Laborprojekt/005_Projekt_Kontrollpanel/Dokumentation/Klemmreihe.jpeg

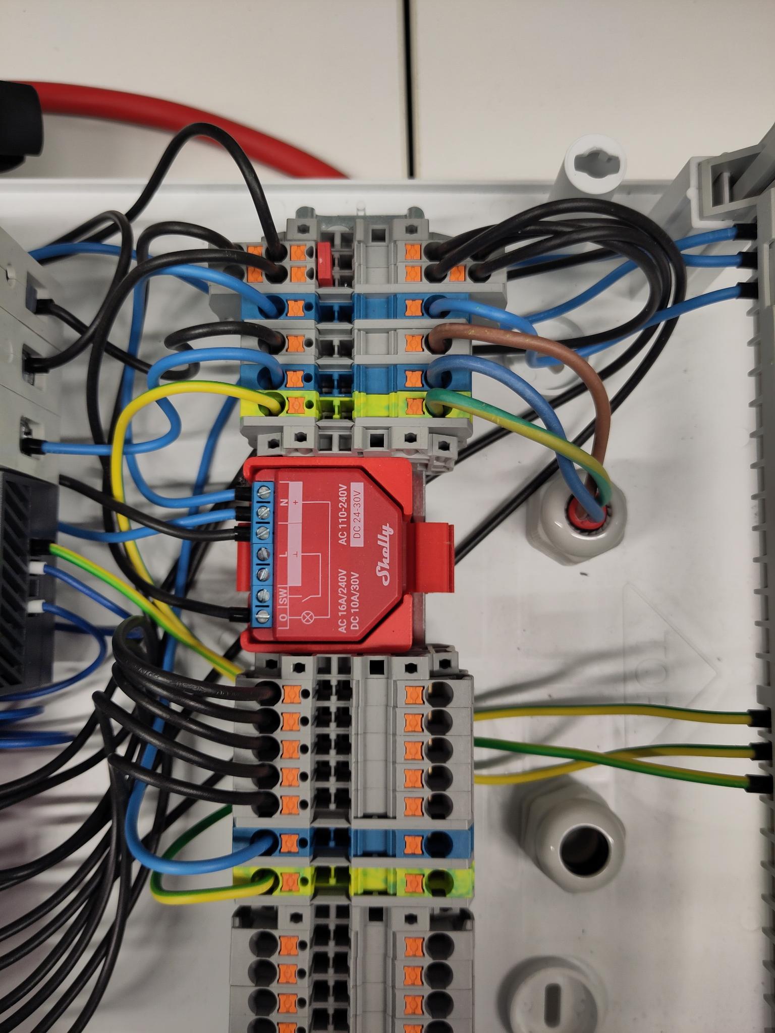
Dokumentation/Klemmreihe.jpeg
