Laborprojekt/005_Projekt_Kontrollpanel/Checkliste IoT Projekt.docx

# Checkliste IoT Projekt

Ansteuerung Node-Red

☒ reboot Relais

☒ Steckdosen einzeln schaltbar

☒ Steckdosen in Gruppen schaltbar

☒ Shelly Schaltbar

☒ Visualisierung

☒ Energiemesswerte

☒ AHT20 Messwerte

☒ Datenbank einbinden

☒ Logs

☒ Messwerte

ESP32

☒ AHT20 auslesen

☐ Display

☒ Energiemesswerte visualisieren

☒ AHT20 Messwerte visualisieren

☐ Display ein- und ausschalten

☐Interrupt Taster

☐ Schuko 1&2

☐ Schuko 3&4

☐ Logs generieren

☐ MQTT-Verbindungen

☐ AHT20 Messwerte übermitteln

☐ Änderungen Schaltzustand

☐Fehlermeldungen
