Laborprojekt/005_Projekt_Kontrollpanel/Dokumentation/Systemarchitektur.pptx

Systemarchitektur

Komponenten
- Prozessor
- Sensor
- Aktor
- Software

Verbindungen:
- MQTT/WIFI
- I2C
- Kupfer
- Interne Schnittstelle

Taster

Schaltzustand

Smartphone

Energiewerte

Schaltbefehl int. Relais

Energiewerte
Schaltzustand

Shelly Plus 1PM

Schaltbefehl int. Relais

AHT 20

Temperatur
Luftfeuchtigkeit

ESP32-S3 Master

Energie Messwerte
Raum Messwerte

Raum Messwerte, Logs/Events
Schaltbefehl Relais

Energiewerte

Schaltbefehl
Relais

Logs/Events

MQTT-Broker

Schaltbefehl Relais, Schaltbefehl Shelly

Logs/Events, Raumwerte, Energiewerte
Schaltzustand Shelly

Node-Red / UI

Logs
Raumwerte
Energiewertet

Display

ESP32-S3
Sub

Schaltbefehl

Relais

Maria-DB
