Laborprojekt/005_Projekt_Kontrollpanel/Ideenskizze/Architektur Projektarbeit.pptx

5. Systemarchitektur

Komponenten:
- Prozessor
- Sensor
- Aktor
- Software

Verbindungen:
- MQTT
- I2C
- Kupfer
- Interne Schnittstellen

Shelly Plus 1 PM

Taster

Schaltzustand

Schaltzustand Aktor

Energie Messwerte

Raum Messwerte, Zustand Taster,
Zustand Steckdose, Logs

AHT20

Temperatur
Luftfeuchtigkeit

ESP32-S3

Schaltzustand

Relais

MQTT-Broker

Messwerte, Logs

Node-RED

Messwerte
Energie und Raum

Energie Messwerte, Zustand Button

Zustand Button

Messwerte
Logs

MariaDB

Display
