Laborprojekt/005_Projekt_Kontrollpanel/Dokumentation/Projektdokumentation.pdf

## BZTG Oldenburg

06.05.2025

# DOKUMENTATION PROJEKTARBEIT

## Jonah Eberlei

## Inhaltsverzeichnis

## Projektbeschreibung und Ideenskizze

## 1. Allgemeine Informationen

- Projektname: Kontrollpanel
- Datum: 11.03.25 – 06.05.25

## 2. Projektbeschreibung

Kurzbeschreibung:

Über Taster und eine Weboberfläche werden Steckdosen geschaltet. Mit zwei Sensoren werden die Raum- und Leistungsdaten erfasst und später auf der Weboberfläche visualisiert. Zusätzlich zur Weboberfläche gibt es ein kleines Display, welches die Daten ebenfalls anzeigt und eine Datenbank, in der die Daten abgelegt werden.

## 3. Anforderungen und Funktionalitäten

Sensorik

- Luftfeuchtigkeit
- Temperatur
- Energiebezug Steckdosen, aktuell und alltime

Aktoren-Steuerung

- Steckdosen
- ESP Hardreset

Webinterface & Benutzerinteraktion

- Visualisierung Energiebezug
- Steckdosen einzeln oder als Gruppe schalten
- Button für ESP Hardreset

## 4. Benötigte Komponenten

### 4.1 Hardware

### 4.2 Software & Datenbank

Komponente | Technologie | Funktion
Microcontroller-Code MicroPython
Webinterface | Node-Red | Visualisierung und Usereingaben
Datenbank | MariaDB
Komponente | Modell/Typ | Funktion
Mikrocontroller | ESP32-S3-DevKit-C
Sensor 1 | AHT20 | Temperatur und Luftfeuchtigkeit
Sensor 2 | Shelly plus 1PM | Energieüberwachung und 1 Schaltaktor
Aktor 1 | SRD-03VDC SL C | 10A Relais
Aktor 2 | 1,69“ IPS Display | Visualisierung
Stromversorgung Mean Well HDR-60-5 | 230V –> 5V Netzteil
Step-Down Modul 3V3 | Spannungsversorgung Relais
Siemens 5SL61166 | B16 LS
Siemens 5SU13566KK10 | B10, 0.03A RCBO
Weitere Bauteile | Taster24V DC, NO | Einschalten des Displays und der Steckdosen
| Hutschiene | Montage Netzteil und RCBO
Steckdosen Gira System/Standart 55
Verschraubung M16 | Zugentlastung
Schuko Stecker | Verbindung Stromnetz
Unterverteilung
Verbindungs und Kleinmaterial

## 6. Zeitplanung (Meilensteine)

Datum | Aufgabe
KW 1 | Detailplanung, Material beschaen
KW 2 | Hardware für Tests zusammenbauen, Ansteuerung Relais
KW 3 | Mit MQTT-Broker und Node-Red verbinden, Shelly einbinden
KW 4 | Taster, AHT und Display einbinden
KW 5 | Node-Red Visualisierung und Buttons einbinden
KW 6 | Logs implementieren, Datenbank verbinden
KW 7 | Bug Fix und Optimierung
KW 8 | Dokumentation

## 7. Offene Fragen & Herausforderungen

- - Der Shelly Schaltaktor arbeitet nicht sauber als NC Kontakt
- - Die Relais benötigen zu viel Energie vom ESP, wenn alle eingeschaltet sind
- - Die Relais reagieren nicht sicher auf Zustandsänderungen

## 8. Zielsetzung

- Das Panel soll mir nach Abschluss der Projektarbeit eine detaillierte Auskunft über den Energieverbrauch der angeschlossenen Geräte und die Umgebungsbedingungen im Raum geben.

## 9. Fazit

Der Frühe Umbau, von der Hutschiene in die Unterverteilung hat alle sehr übersichtlich gestaltet und alle weiteren arbeiten vereinfacht. Durch die Vorbereitung im Unterricht, war die Programmierung der MQTT-Schnittstelle und Node-Red schnell grundlegend bearbeitet. Durch die Unterstützung der KI-Modelle waren auch die fehlenden Java-Script Kenntnisse, die ebenfalls für den Shelly benötigt werden, kein großes Hindernis und die Fehler konnten schnell beseitigt werden.
Was ich stark unterschätzt habe, war die Kostenentwicklung und der Einfluss von EMV auf unsere Microcontroller. Die Taster Signale (Interrupts) leiden aufgrund der geringen Spannung sehr unter Einstreuungen, die u.a. beim Schalten des internen Shelly Relais entstehen. Für einen praktischen Anwendungsfall würde ich meine Taster nicht erneut über einen ESP die Relais ansteuern lassen oder die Steuerspannung erhöhen. Der Eekt der Einkopplungen wird durch die parallel liegenden Leitungen und die allgemeine Länge der Leitung verstärkt. 24V wäre beispielsweise deutlich weniger störanfällig als die 3,3V des ESP. Direkt alles nur über Shelly steuern zu lassen oder als Controller eine LOGO/SPS zu nehmen, würde die Fehleranfälligkeit und die Kostenentwicklung deutlich senken.

Um das ganze mit dem ESP umzusetzen war viel Kleinmaterial und teilweise auch ausprobieren nötig, bis ich das richtige Material gefunden habe. Das hat die Kosten nach oben getrieben, da es bei Leitungen zum Teil. mindestlängen gibt, die gekauft werden müssen.

Insgesamt konnte ich bei dem Projekt einige Dinge lernen, die ich in Zukunft anders machen würde. Ich hatte viel Spaß beim Zusammenbau der Unterverteilung, während meiner Leerlaufzeit bei einer Ferienveranstaltung. Ich konnte mehreren interessierten Teilis dadurch das Thema anschaulich erklären und ihnen das Feld der Elektrotechnik etwas näherbringen.

## 10. GITHUB Repository

https://github.com/Laborprojekt/005_Projekt_Kontrollpanel

## 11. Erweiterungen

- Leuchttaster, die den Schaltzustand angeben
o War integriert, musste aufgrund der EMV-Probleme aber zurückgebaut werden, als der zweite ESP die Steuerung integriert wurde. Die Spannungsversorgung der 12V LED-Ringe war nicht mehr möglich
- Remote-Red Anbindung
o Wurde bereits integriert

## Installationsanleitung Kontrollpanel

## Montage Unterverteilung:

Im ersten Schritt müssen die Löcher für die Unterverteilung am Montageort vorgebohrt werden. Die Schraubenlöcher haben einen Durchmesser von 4mm.
Abstände:
A 526mm
B 287mm
C 112mm
D 357mm
E 180mm

Quelle: https://intratec-shop.de/sicherungskasten-verteiler-aufputz-3-reihig-ip40-36-module-weisse-tuer/MKCAGH36-W

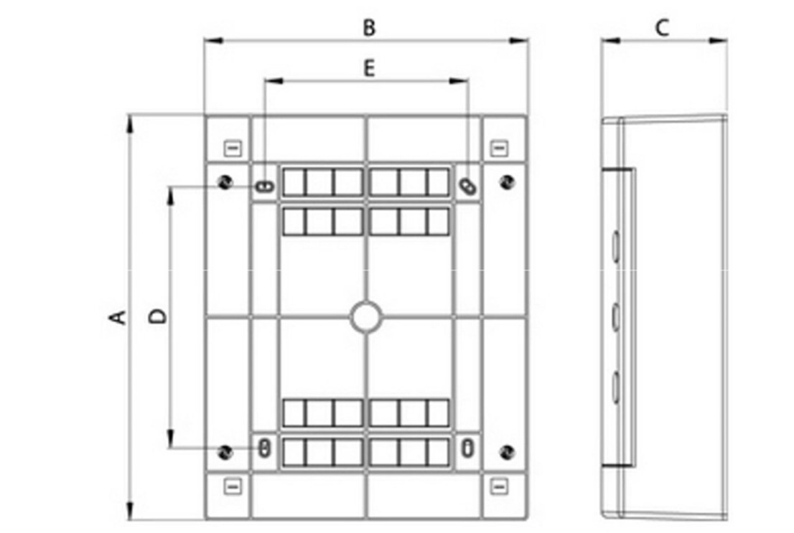
[picture p2: figure]

Wenn die Leitungen nicht unterputz verlegt wurden, müssen bei der Montage

### 40 mm-60 mm Distanzstücke verwendet werden, um den Unterverteiler von der

Montagefläche abzusetzen. Wird dies nicht getan, kann der Biegeradius der Anschlussleitung nicht eigehalten werden.

## Anschließen der Ein- und Ausspeisung

Einspeisung:
- 230V
- 1.5 mm² - 4 mm²
- Vorsicherung 16A/25A
Ausspeisung:
- 230V
- 1.5 mm² - 2.5 mm²
Strombelastbarkeit:
Einzelader: 10A / 2300 Wp
Insgesamt: 10A / 2300 Wp
Dauerlast: 8A / 1840 W

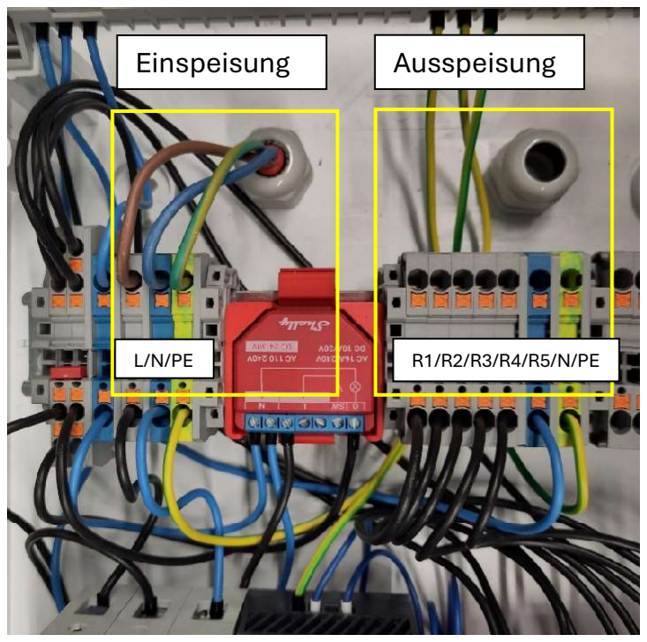
[picture p3: figure]
Einspeisung; Ausspeisung

## Inbetriebnahme durch eingewiesene EFK

- Inbetriebnahmeprüfung nach DIN VDE 0100 Teil 600 und DIN VDE 0701/0702
- Anpassen der Netzwerk- und MQTT-Parameter:
o ESP Master
o ESP Sub
o Shelly plus 1 pm
o Node-Red
o MariaDB

## Bedienungsanleitung Kontrollpanel

## 1. Hardwareinformationen

ESP32-S3-DevKitC-1
Das ESP32-DevKitC ist ein kompaktes und kostengünstiges Entwicklungsboard auf Basis des ESP32-Chips von Espressif. Es eignet sich ideal für Einsteiger und Fortgeschrittene, die IoT-, Sensor- oder Automatisierungsprojekte entwickeln wollen. Merkmale:
- Mikrocontroller: ESP32 (Dual-Core, 32 Bit, 240 MHz)
- Speicher: 520 KB SRAM, 16 MB Flash
- Konnektivität:
o WLAN 802.11 b/g/n
o Bluetooth 4.2 (Classic & BLE)
- Anschlüsse:
o GPIOs
o SPI, I2C, UART, PWM, ADC, DAC
- USB-C Anschluss: Für Programmierung und Stromversorgung (über UART-Bridge)
- Stromversorgung: 5 V/3V3
- Unterstützung: Kompatibel mit Arduino, MicroPython, ESP-IDF

Q(ESP)

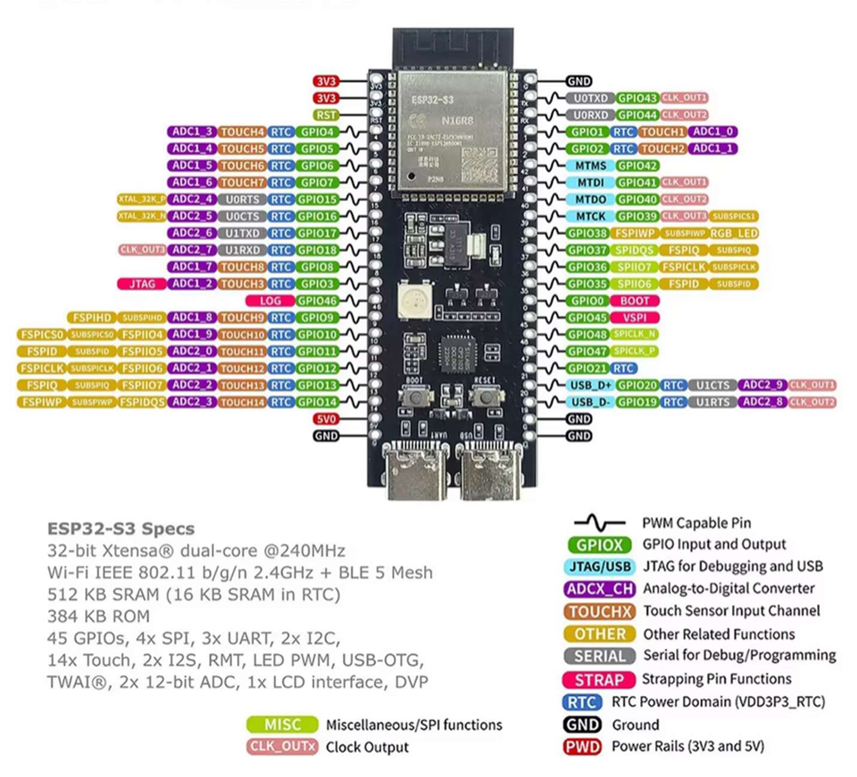
[picture p4: figure]

AHT20
Der AHT20 ist ein digitaler Sensor zur Messung von
Temperatur und relativer
Luftfeuchtigkeit.
Eigenschaften:
- Messbereich

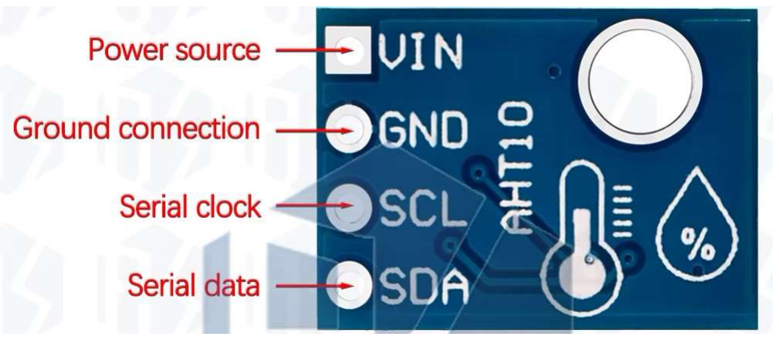
[picture p5: figure]

Temperatur: -40 °C bis +85 °C
- Genauigkeit Temperatur: ±0,3 °C
- Messbereich Luftfeuchtigkeit: 0 % bis 100 % relative Luftfeuchte
- Genauigkeit Luftfeuchtigkeit: ±2 %
- Spannungsversorgung: 2,2 V – 5,5 V
- Kommunikation: I2C

Q(AHT)
Shelly plus 1 PM

Der Shelly Plus 1PM ist ein kompakter Smart-Schalter mit integrierter Leistungsmessung, der die Fernsteuerung elektrischer Geräte über ein Smartphone, Tablet, einen PC oder ein Heimautomatisierungssystem ermöglicht.
Er kann eigenständig in einem lokalen WLAN-Netzwerk betrieben werden oder über Cloud-basierte Smart-Home-Dienste gesteuert werden. Er unterstützt zudem MQTT, WSS, TLS und kundenspezifische Zertifikate.
Der Shelly Plus 1PM kann von überall aus ferngesteuert, überwacht und konfiguriert werden, solange der Benutzer über eine Internetverbindung verfügt und das Gerät mit einem WLAN-Router und dem Internet verbunden ist.
Er lässt sich problemlos in Standard-Unterputzdosen, hinter Steckdosen und Lichtschaltern oder an anderen Orten mit begrenztem Platzangebot nachrüsten.
Der Shelly Plus 1PM verfügt über eine integrierte Weboberfläche, mit der sich das Gerät überwachen, steuern und konfigurieren lässt.

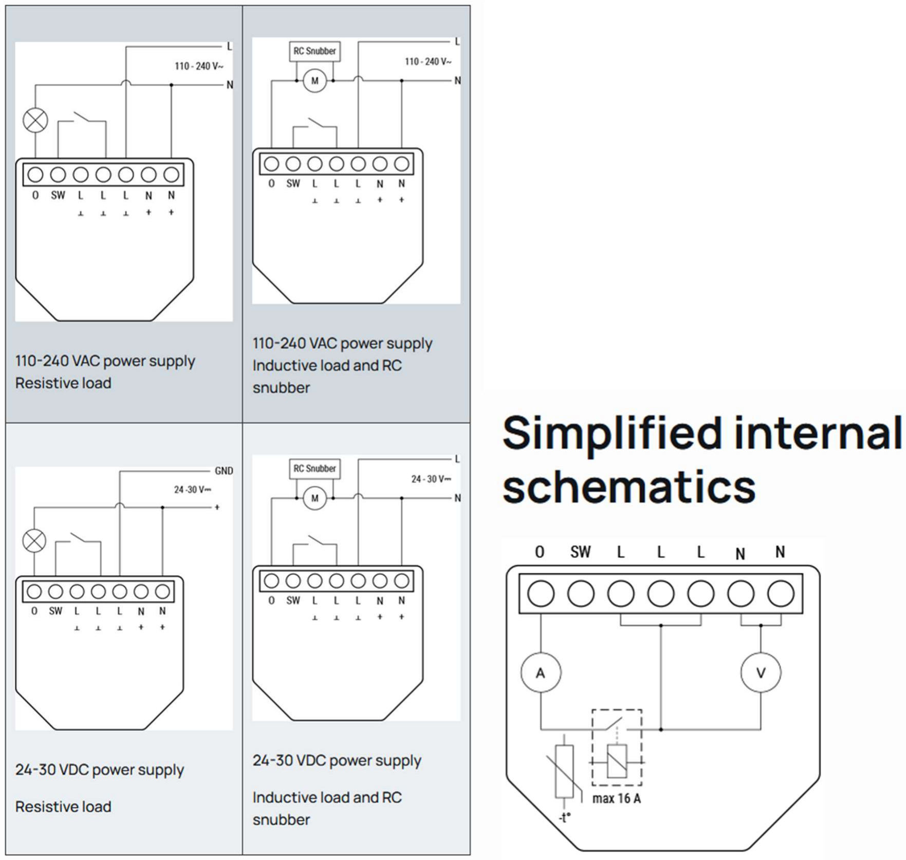
[picture p6: figure]

Q(Shelly)

ST7789V3, 1.69", 240x280p

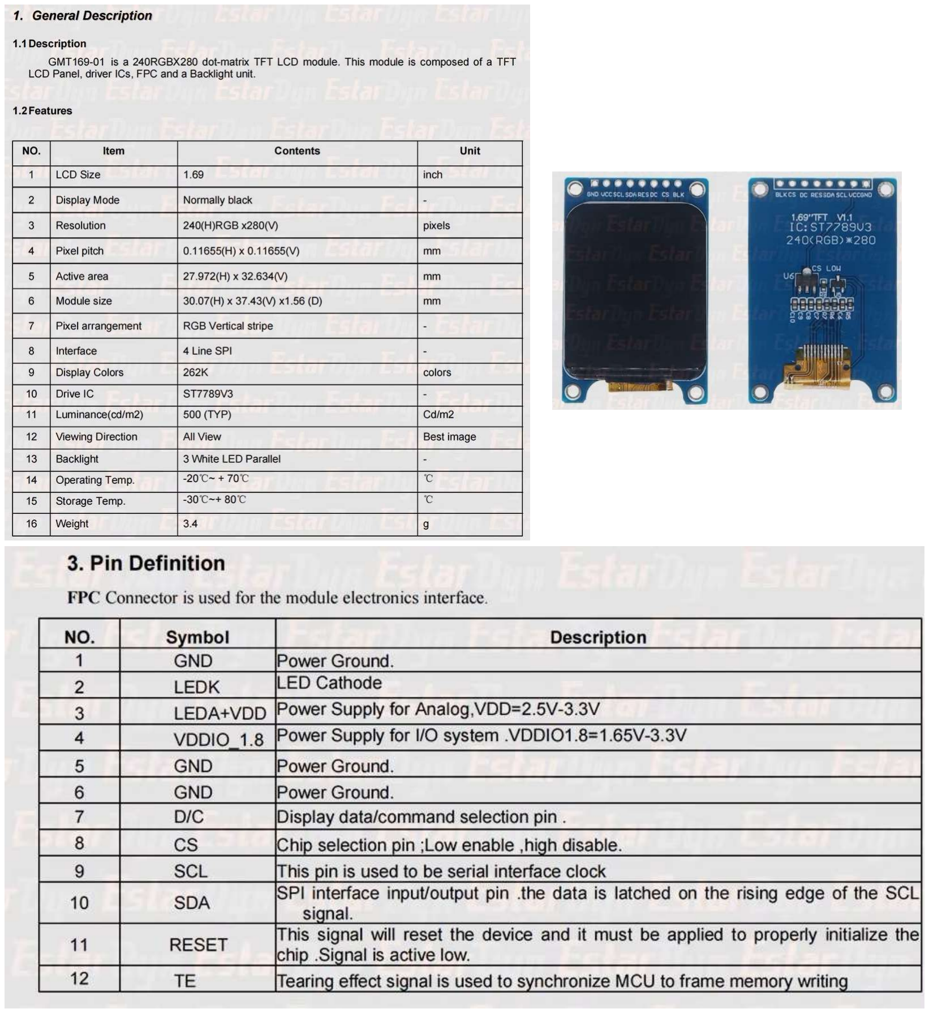
[picture p7: figure]
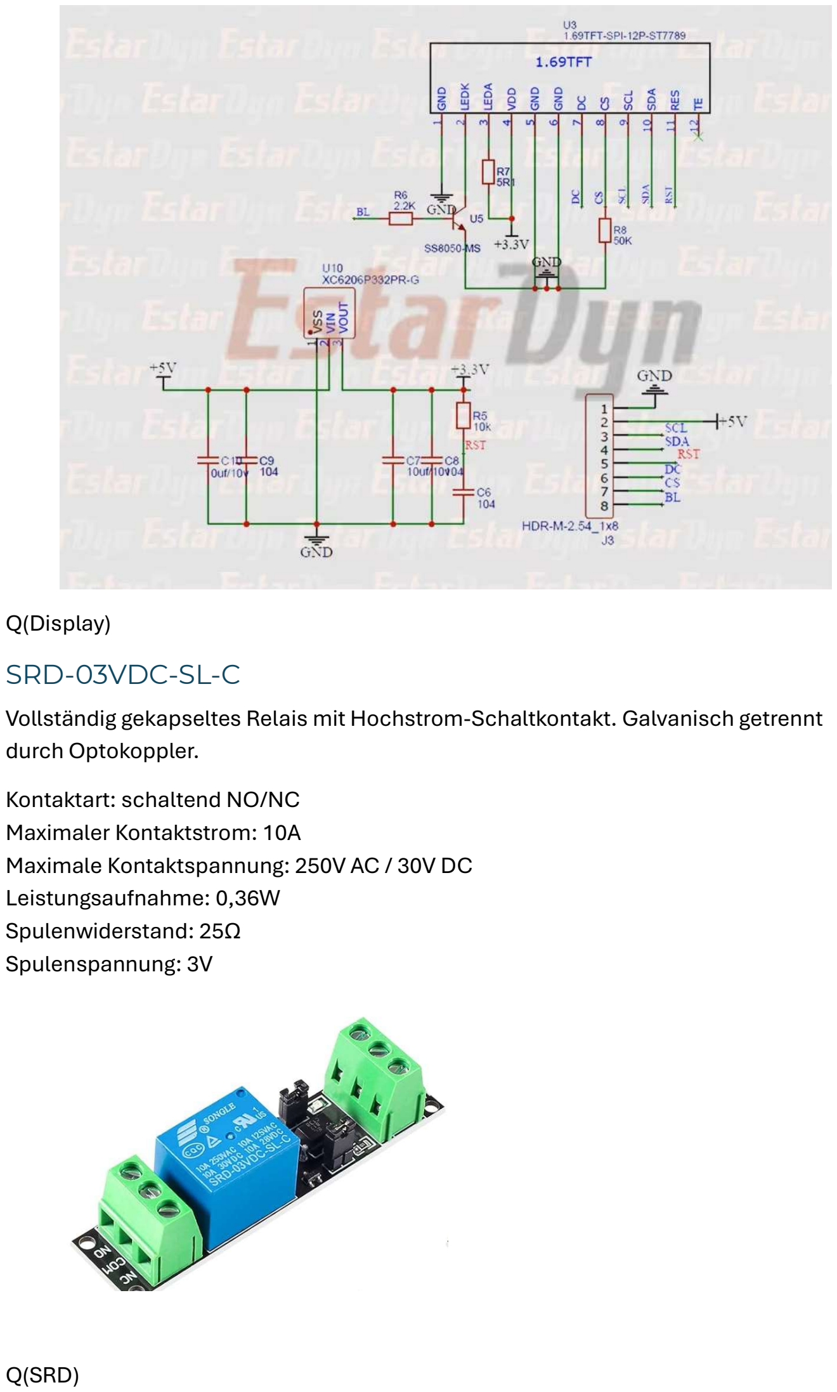
[picture p8: page 14]

Q(Display)
SRD-03VDC-SL-C
Vollständig gekapseltes Relais mit Hochstrom-Schaltkontakt. Galvanisch getrennt durch Optokoppler.
Kontaktart: schaltend NO/NC
Maximaler Kontaktstrom: 10A
Maximale Kontaktspannung: 250V AC / 30V DC Leistungsaufnahme: 0,36W
Spulenwiderstand: 25Ω
Spulenspannung: 3V

Q(SRD)

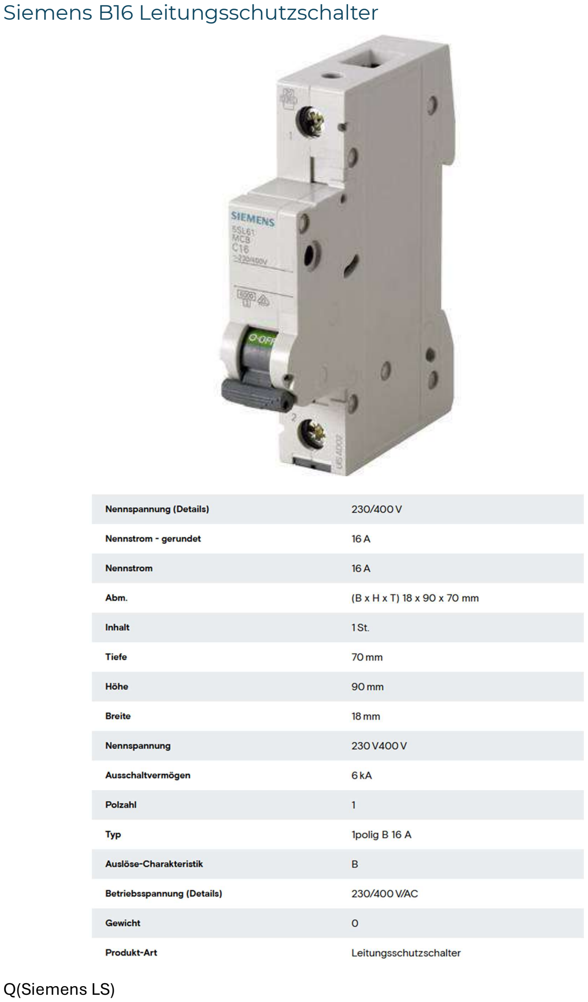
[picture p9: page 15]

Siemens B16 Leitungsschutzschalter

Q(Siemens LS)

Siemens B10 FI/LS

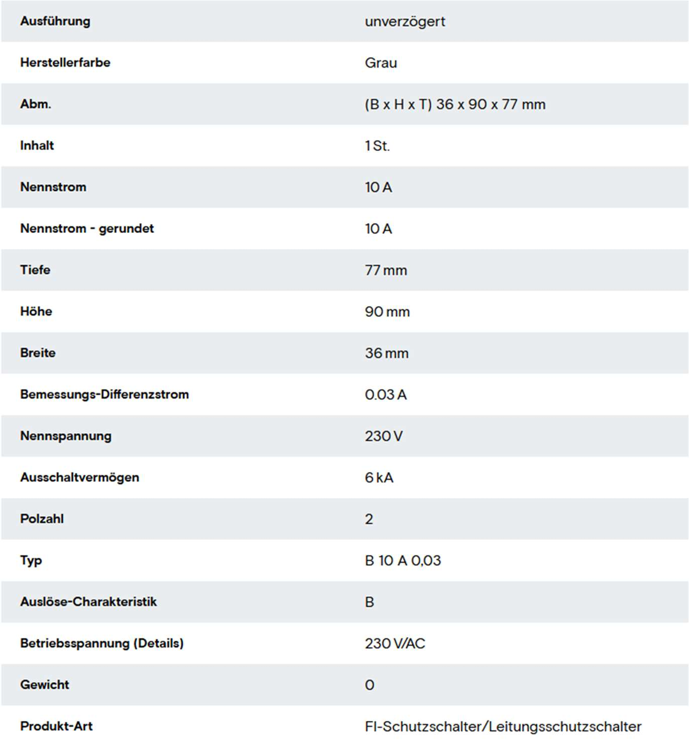
[picture p10: figure]

Q(Siemens FI/LS)

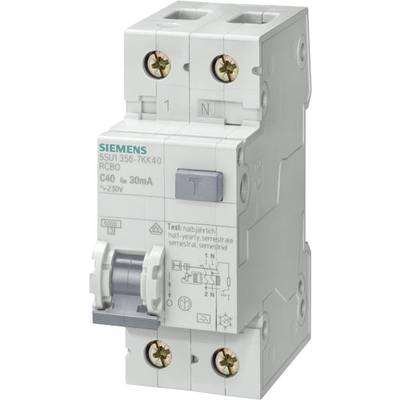
[picture p11: figure]

MeanWell HDR-60-5
Hersteller: MeanWell
Hersteller Serie: HDR-60
Herstellerartikelnummer: HDR-60-5 Anschluss Ausgang: Schraubklemmen Anschluss Netzeingang: Schraubklemmen Breite: 62mm
Höhe: 62mm
Länge: 92mm
Ausgangsspannung: +5V
Ausgangsstrom: 6,5A
Eingang (AC/DC): AC
Eingangsspannung: 115V / 230V (Universal) Eingangsspannung (min...max): 85...264VAC Leistung: 60W
Netzteil Serie: HDR-60
Netzteil Typ: Hutschienen Netzteil Stabilisierung: Konstantspannung (CV) Wirkungsgrad: 89%

Q(MeanWell HDR)

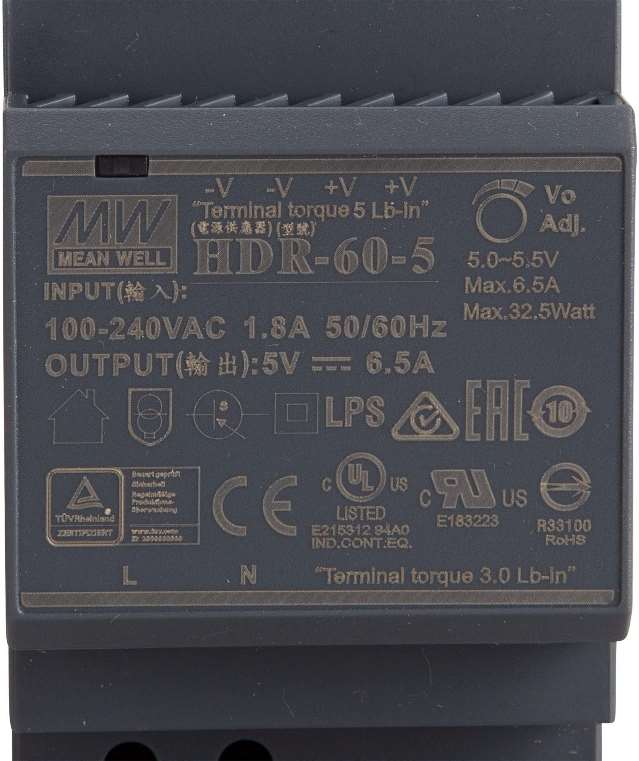
[picture p12: figure]
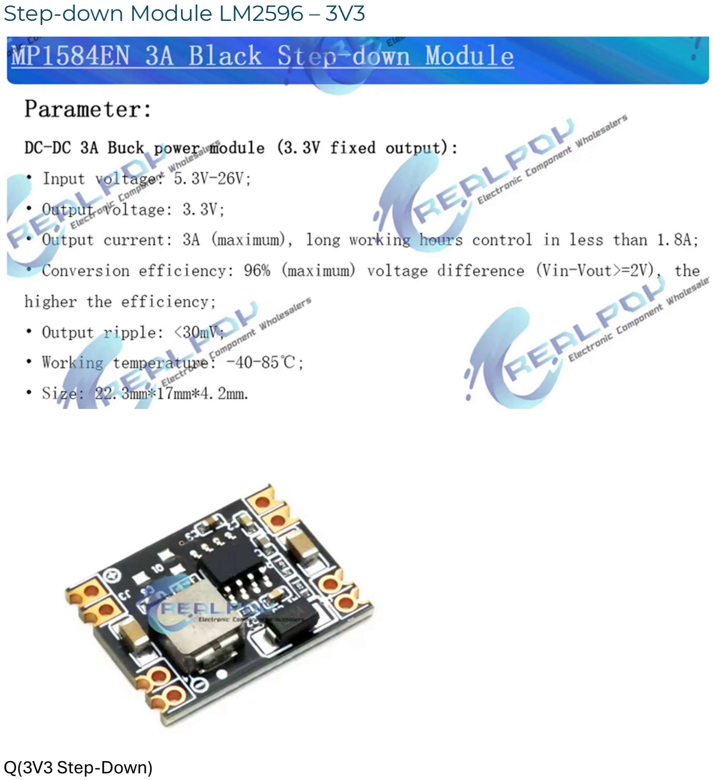
[picture p13: page 18]

Step-down Module LM2596 – 3V3

Q(3V3 Step-Down)

## 2. Systemarchitektur

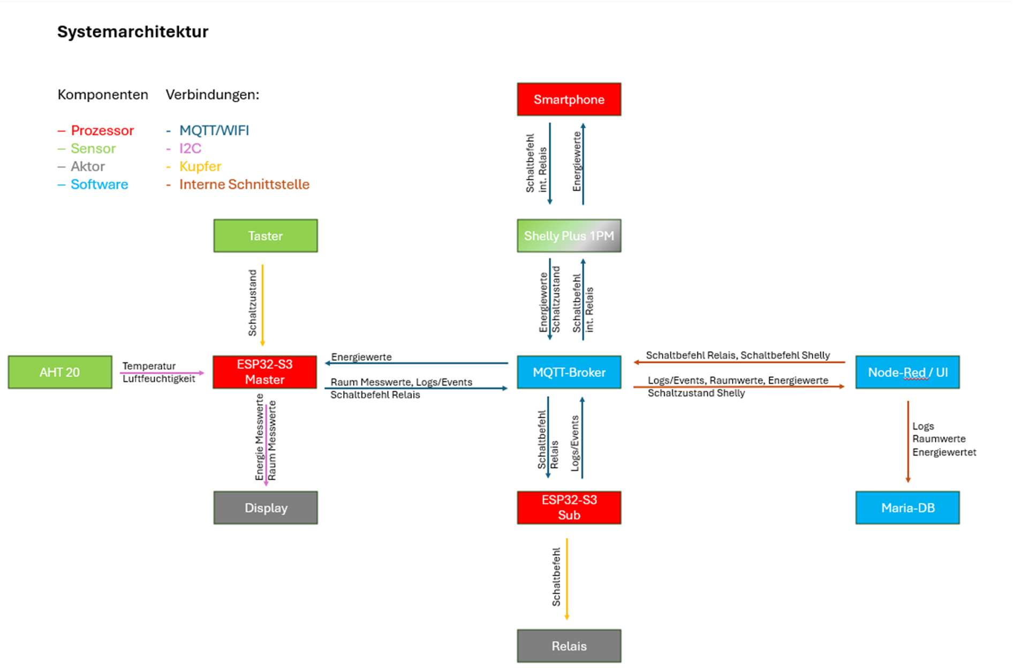
[picture p14: figure]

## 3. Broker und Datenbank

Topics
Topic | Sender | Empfänger | Beschreibung
ESP_AHT | ESP Master | Datenbank | Messwerte zu Luftfeuchtigkeit und Temperatur
ESP_logs | ESP Master / ESP Sub | Datenbank | Systemstatus und Fehlermeldungen
Node-red_relais_button | Node-Red, ESP Master | ESP Sub | Schaltbefehl der Relais auf dem HMI und Interrupts der Taster
Node-red_shelly_button | Node-Red | Shelly | Hauptschalter für das interne Relais des Shelly
shelly_energydata | Shelly | ESP Master / Datenbank | Messwerte und Sytemparameter des Shelly plus 1 PM
Shelly_switch_state | Shelly | Node-Red | Schaltzustand des Shelly

Datenbank Software
Backend: Maria DB
Visualisierung: Heidi SQL
Energiedaten

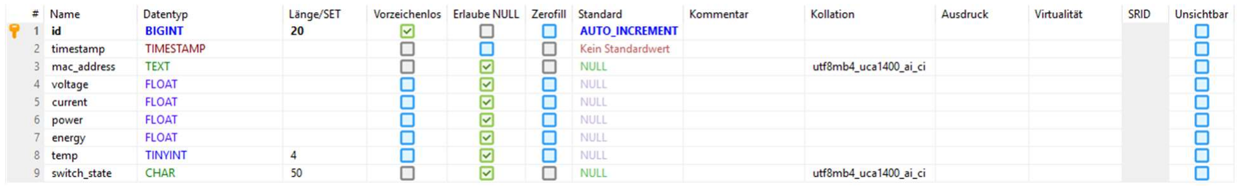
[picture p15: figure]

Logs

Raumdaten

## 4. Shelly

Shelly in App einbinden
Schritt 1: Auf das blaue Plus in der unteren rechten Ecke klicken

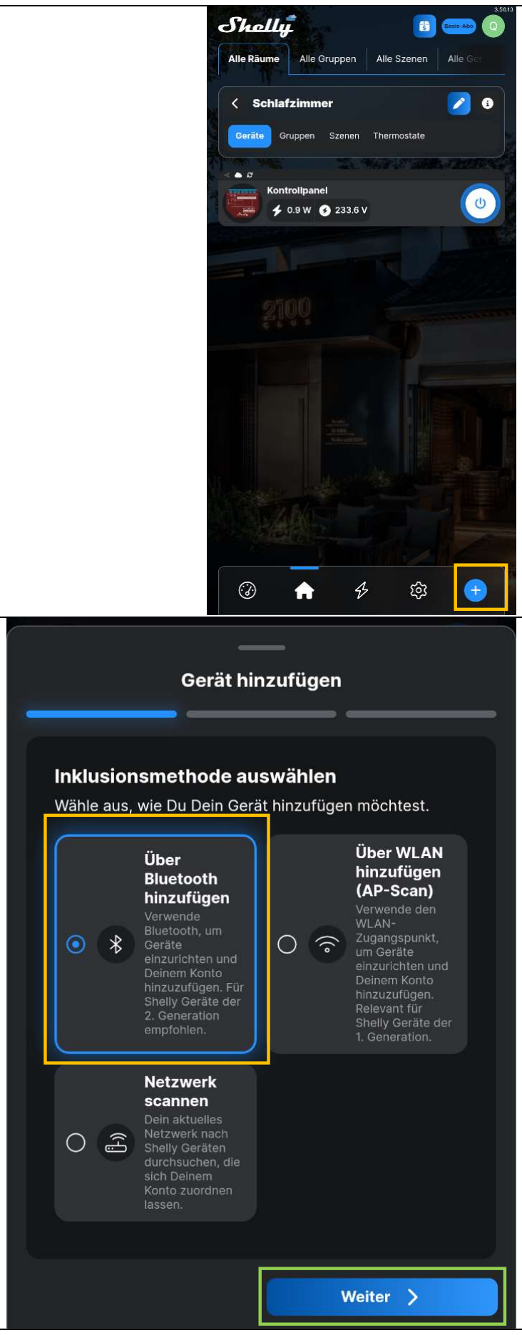
[picture p16: figure]

Schritt 2: Verbindungsmethode auswählen. Im Beispiel verwenden wir die Bluetooth Schnittstelle

Schritt 3: Klicken Sie auf „Weiter“

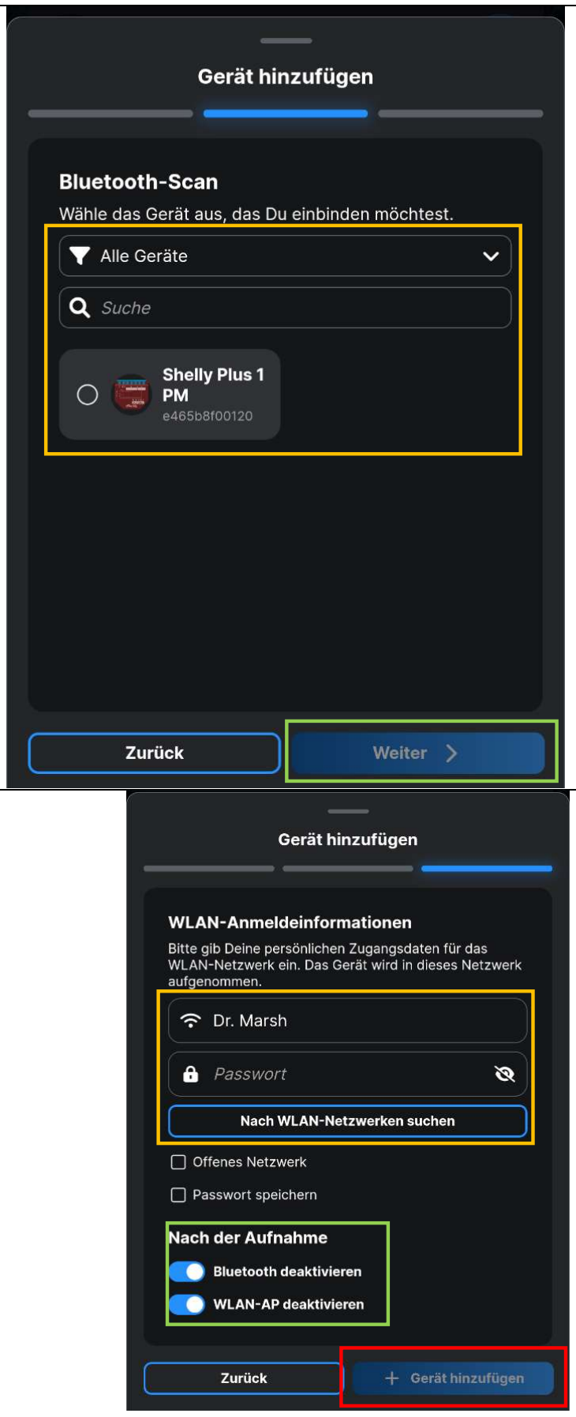
[picture p17: figure]

Schritt 4: Wählen Sie das Gerät aus, welches Sie hinzufügen möchten. Taucht es nicht in der Liste auf, stellen Sie den Filter auf „Alle Geräte“

Schritt 5: Klicken Sie auf „Weiter“

Schritt 6: Geben Sie die Zugangsdaten zur Ihrem W-LAN Netzwerk ein

Schritt 7: Optional können nach dem herstellen der W-LAN Verbindung die Kopplungsoptionen über den W-LAN Access Point und die Bluetooth Schnittstelle deaktiviert worden. Diese werden standartmäßig ausgeschaltet

Schritt 8: Klicken Sie auf „+ Gerät hinzufügen“. Dann verbindet sich das Gerät mit dem Netzwerk und der Shelly startet sich neu.
Die Einrichtung ist nun abgeschlossen und Sie können die individuelle Konfiguration in den Einstellungen vornehmen

MQTT und Netzwerk parametrieren
Wählen Sie den gewünschten Schalt
Aktor aus

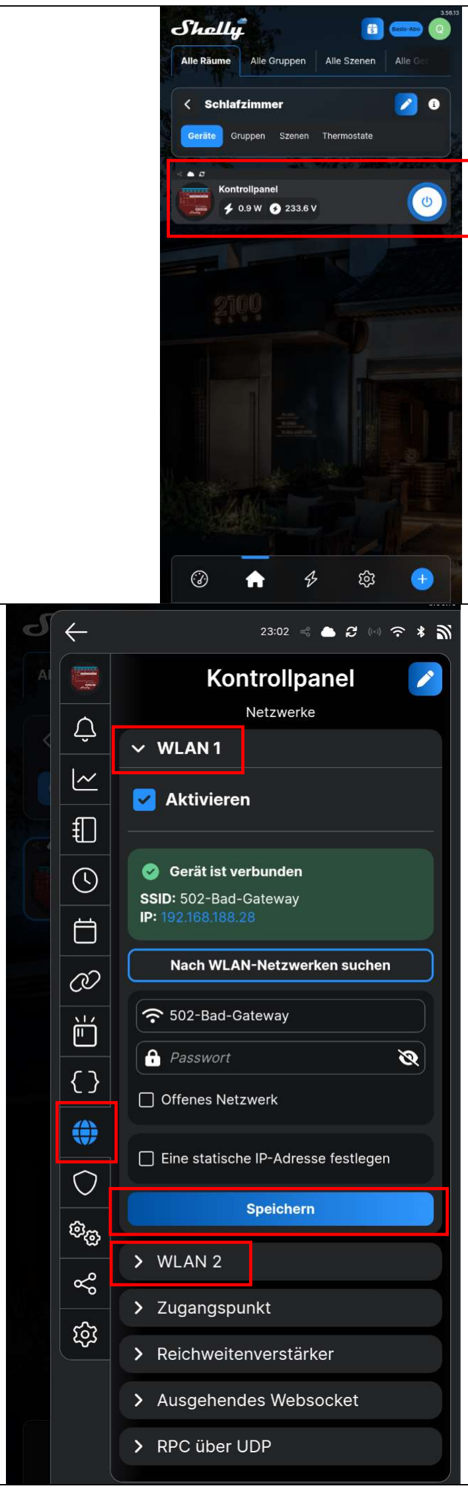
[picture p18: figure]

Im Verbindungs-Menü kann die Parametrierung von Wifi und Protokollen vorgenommen werden. Der Shelly unterstützt bis zu 2 gespeicherte W-LAN Netzwerke.

Durch das Drücken auf „Speichern“, verbindet sich der Shelly mit dem Netzwerk und verbindet sich dann automatisch, wenn das Netzwerk in Reichweite ist.

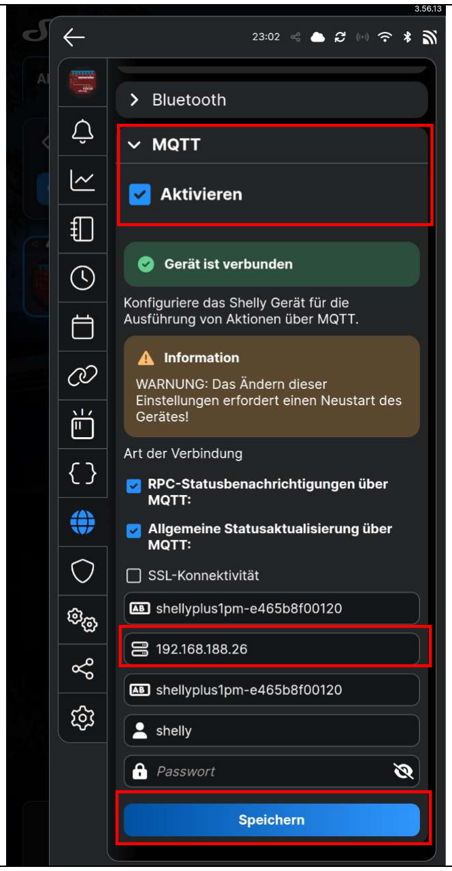
[picture p19: figure]

MQTT

Die für uns wichtigste Einstellung ist die Broker IP. Der Rest muss nicht angepasst werden.

Auch hier werden die Einstellungen durch das Drücken auf „Speichern“ übernommen und der Shelly muss neu gestartet werden.

Skripte auf Shelly aktivieren
Hauptmenü:

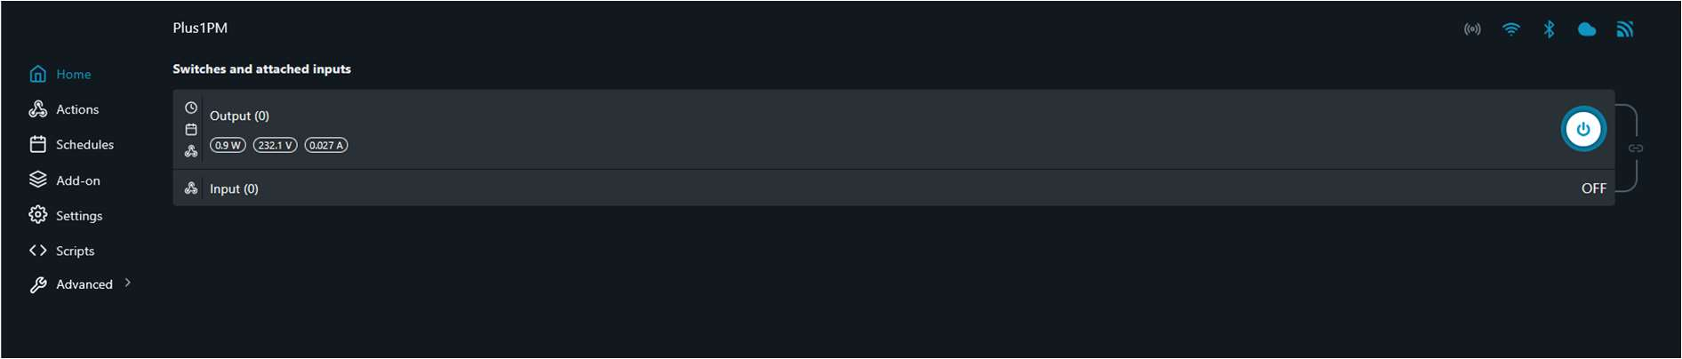
[picture p20: figure]

Untermenü zum Erstellen, Bearbeiten, Aktivieren und Deaktivieren der Skripte. Die Skripte können ebenfalls in der App angesehen und gesteuert werden. Für das Editieren empfehle ich aber die Weboberfläche.

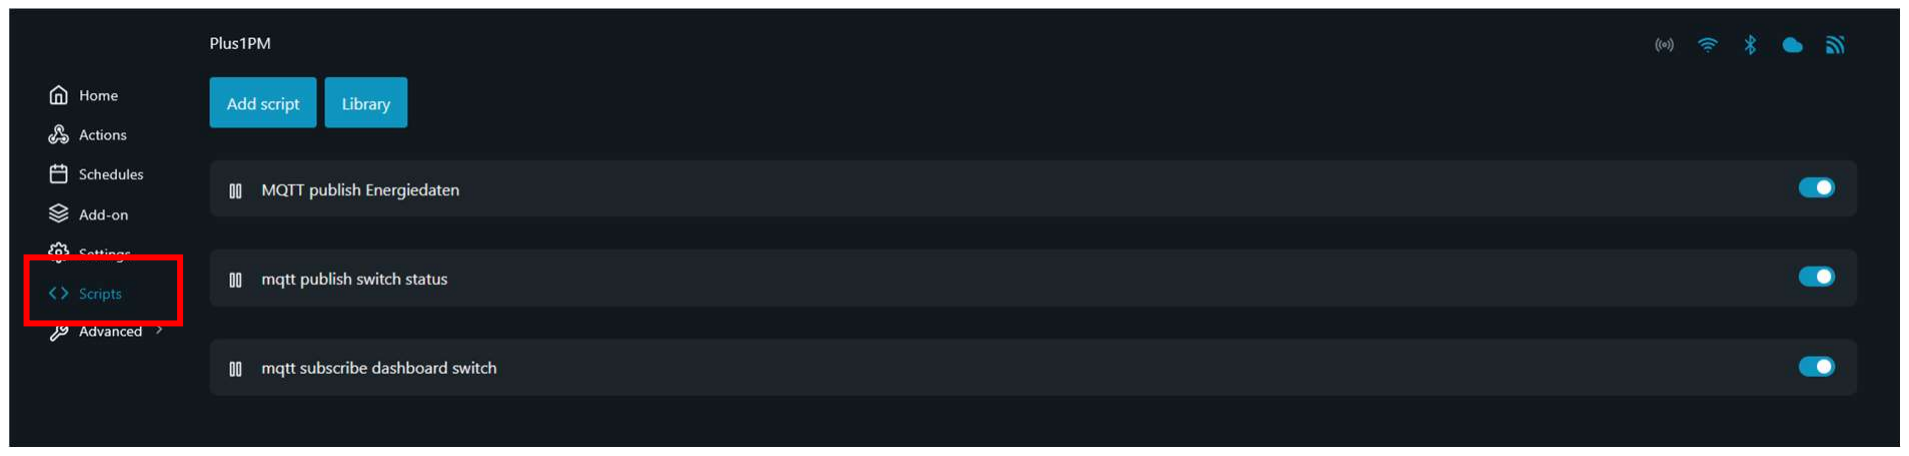
[picture p21: figure]

## 5. Node-Red

Bedienelemente
Gruppenschaltung Steckdose
- Schaltet alle Steckdosen gesammelt ein oder aus Button Steckdosen
- Wechselt den Schaltzustand der jeweiligen Steckdosengruppe oder Steckdose
o Ein -> Aus
o Aus -> Ein
Hardreboot ESP
- Trennt die Stromversorgung vom ESP und erzwingt dadurch einen Neustart
Shelly Relais toggle
- Wechselt den Schaltzustand internen Shelly Relais
o Ein -> Aus
o Aus -> Ein

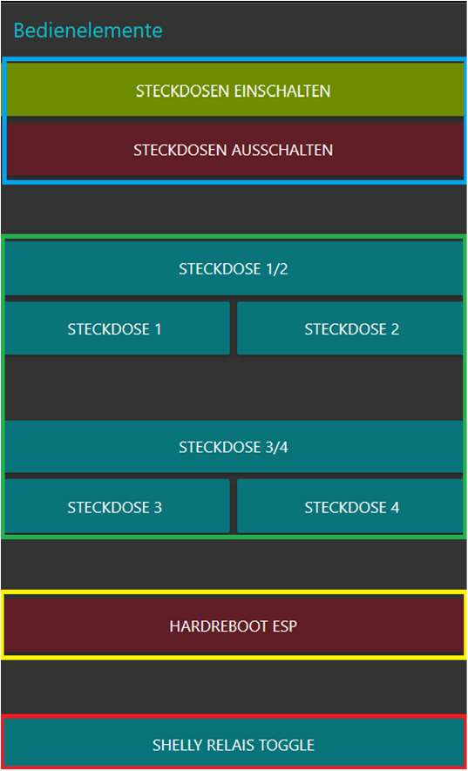
[picture p22: figure]

- Ist das Relais ausgeschaltet wird das Netzteil, der ESP und die Steckdosen nicht mit Strom versorgt. Das Relais kann über die Shelly App oder die Node-Red Weboberfläche geschaltet werden.

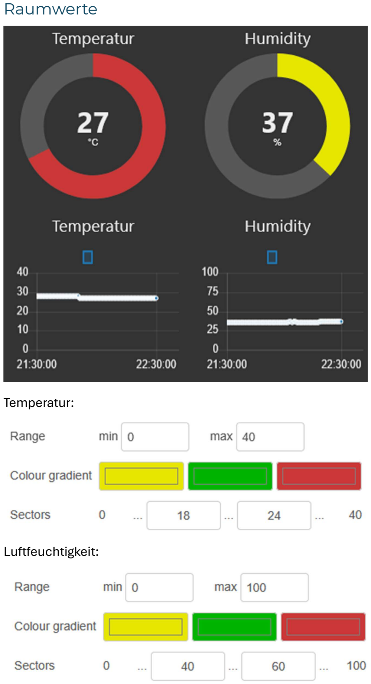
[picture p23: page 27]

Raumwerte

Temperatur:

Luftfeuchtigkeit:

Energiewerte

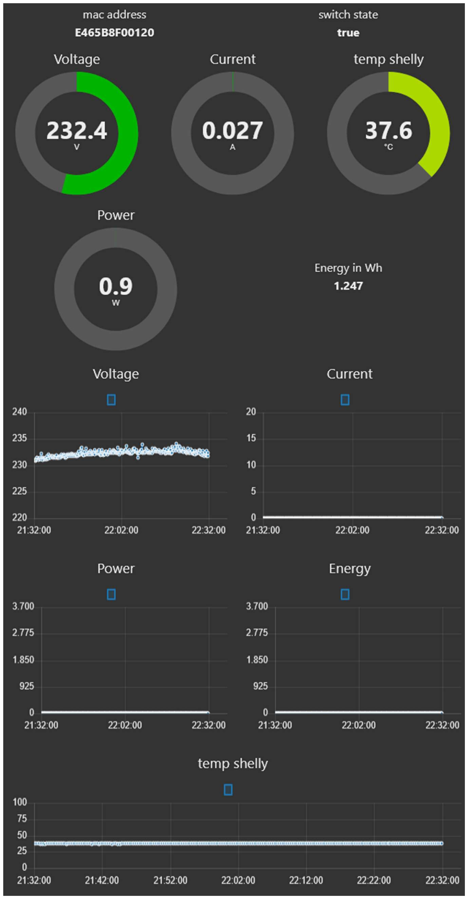
[picture p24: figure]

*Der Energieverbrauch setzt sich beim Neustart des Shelly‘s zurück

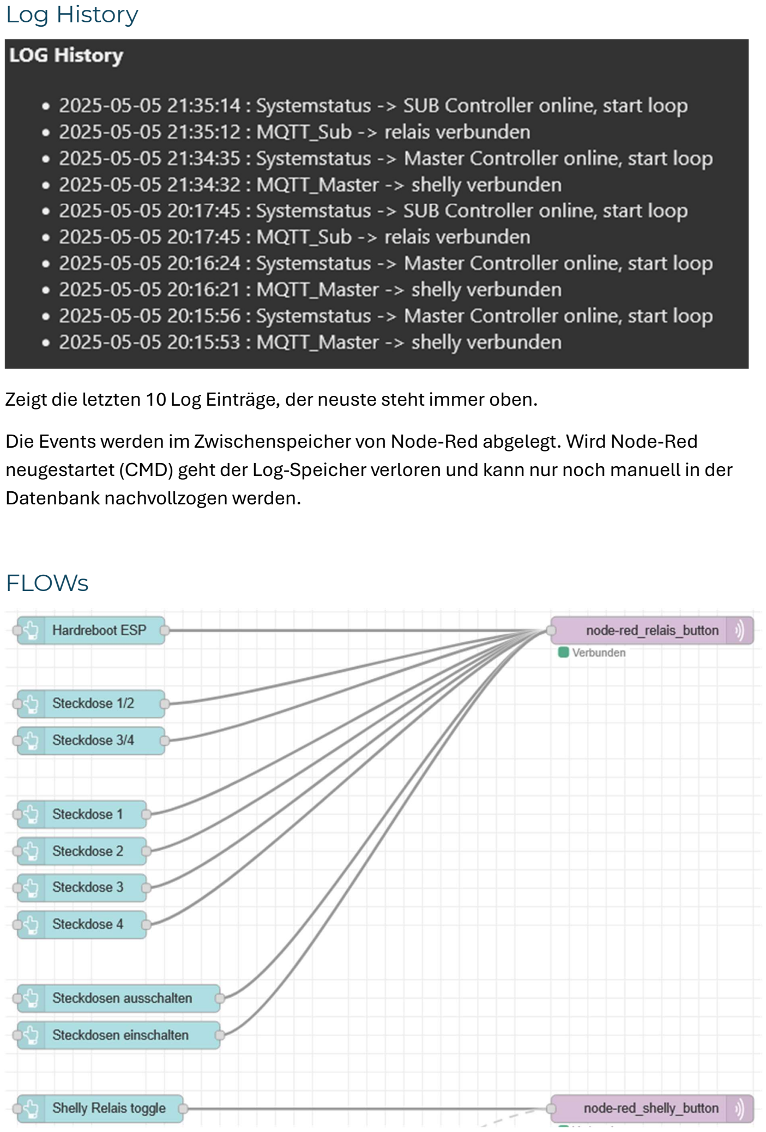
[picture p25: page 29]

Log History

Zeigt die letzten 10 Log Einträge, der neuste steht immer oben.
Die Events werden im Zwischenspeicher von Node-Red abgelegt. Wird Node-Red neugestartet (CMD) geht der Log-Speicher verloren und kann nur noch manuell in der Datenbank nachvollzogen werden.

FLOWs

Inhalt Buttons:

Button | JSON
Hardreboot ESP | {„reboot“ : 1}
Steckdose 1/2 | {"schuko12" : 1}
Steckdose 3/4 | {"schuko34" : 1}
Steckdose 1 | {"schuko1" : 1}
Steckdose 2 | {"schuko2" : 1}
Steckdose 3 | {"schuko3" : 1}
Steckdose 4 | {"schuko4" : 1}
Steckdose ausschalten | {"group_o" : 1}
Steckdose einschalten | {"group_on" : 1}
Shelly Relais toggle | {"switch_state" : "toggle"}

Die Daten werden dann an das zugehörige Topic geschickt und durch den Sub ESP ausgewertet.

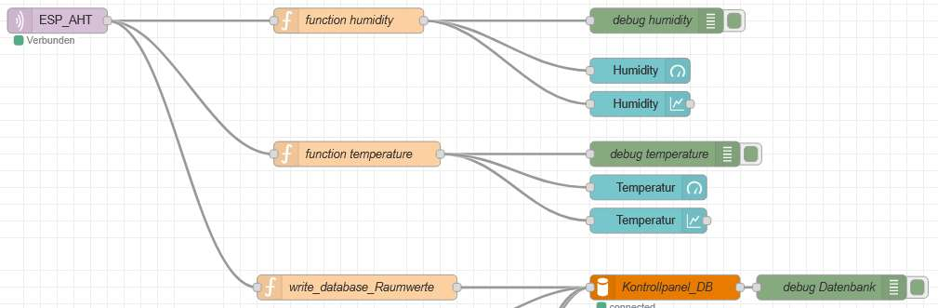
[picture p26: figure]

function humidity – auslesen der Werte aus JSON

function temperature - auslesen der Werte aus JSON

write database Raumwerte – Werte an Datenbank senden

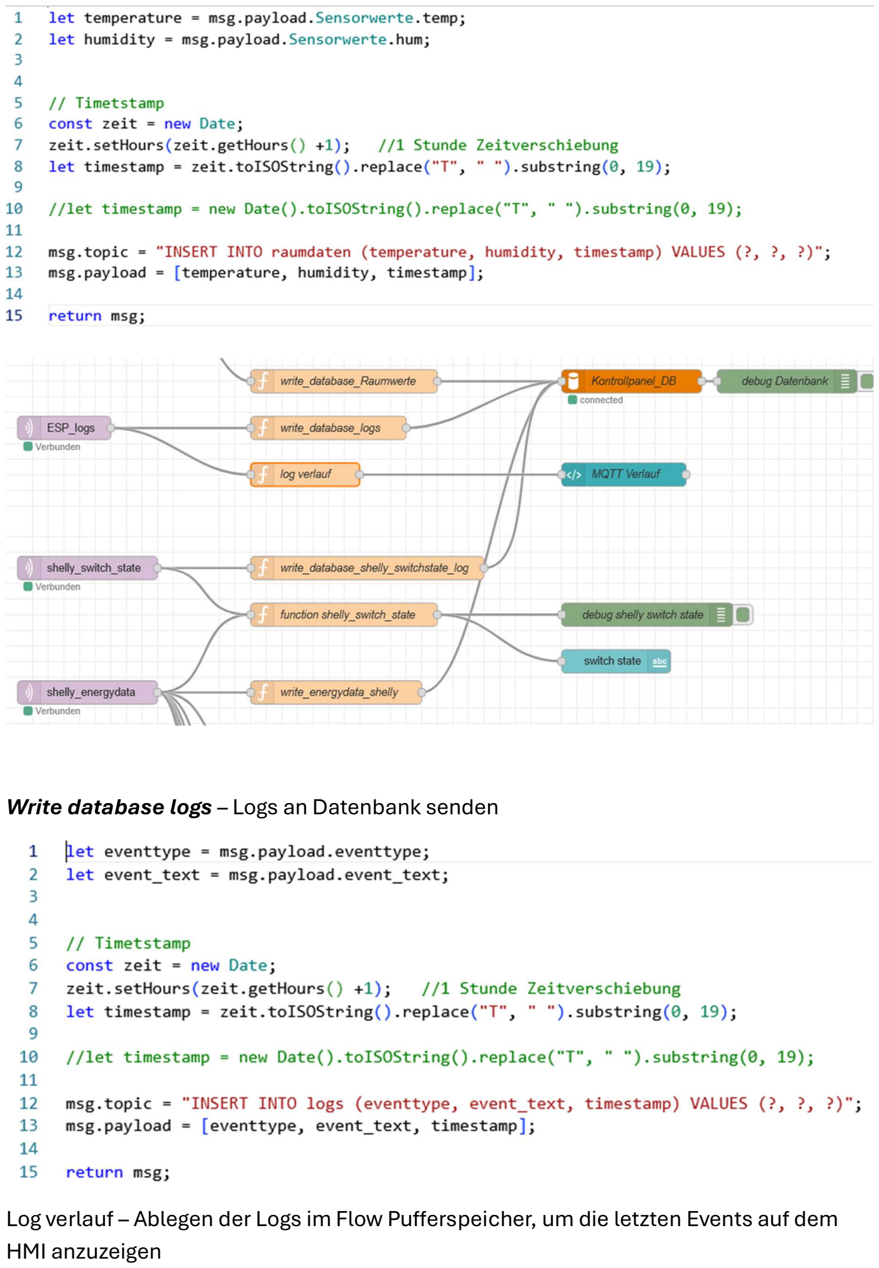
[picture p27: page 31]

Write database logs – Logs an Datenbank senden

Log verlauf – Ablegen der Logs im Flow Puerspeicher, um die letzten Events auf dem HMI anzuzeigen

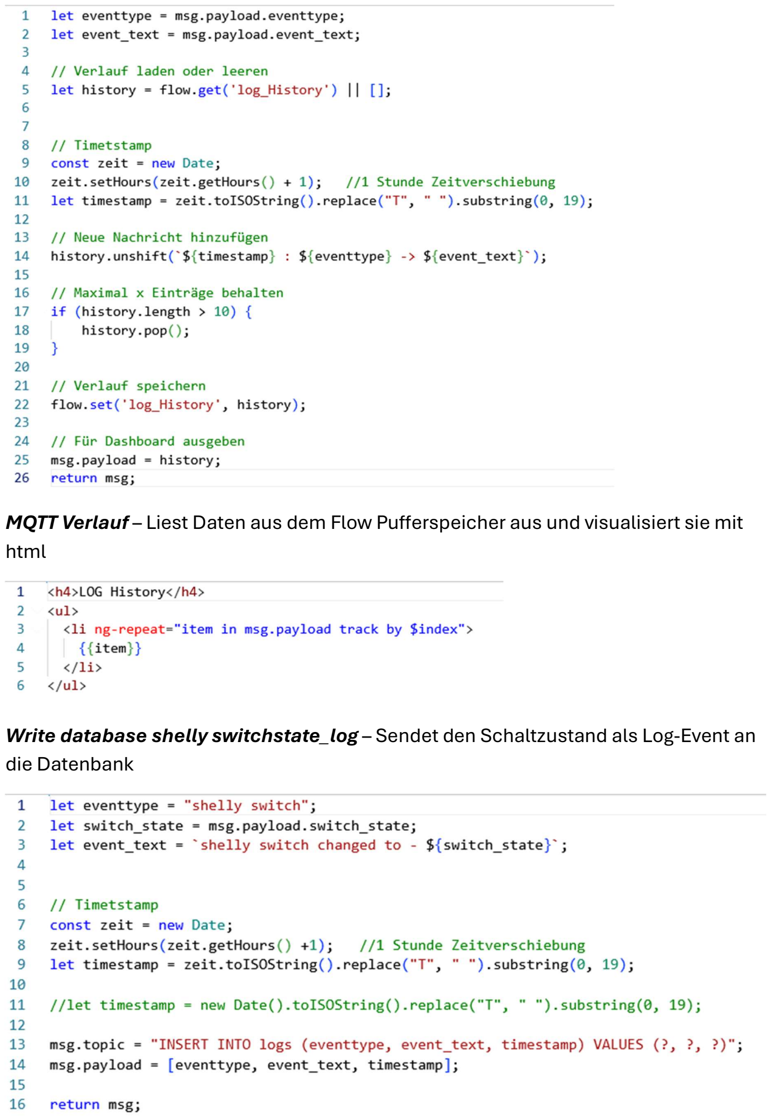
[picture p28: page 32]

MQTT Verlauf – Liest Daten aus dem Flow Puerspeicher aus und visualisiert sie mit html

Write database shelly switchstate_log – Sendet den Schaltzustand als Log-Event an die Datenbank

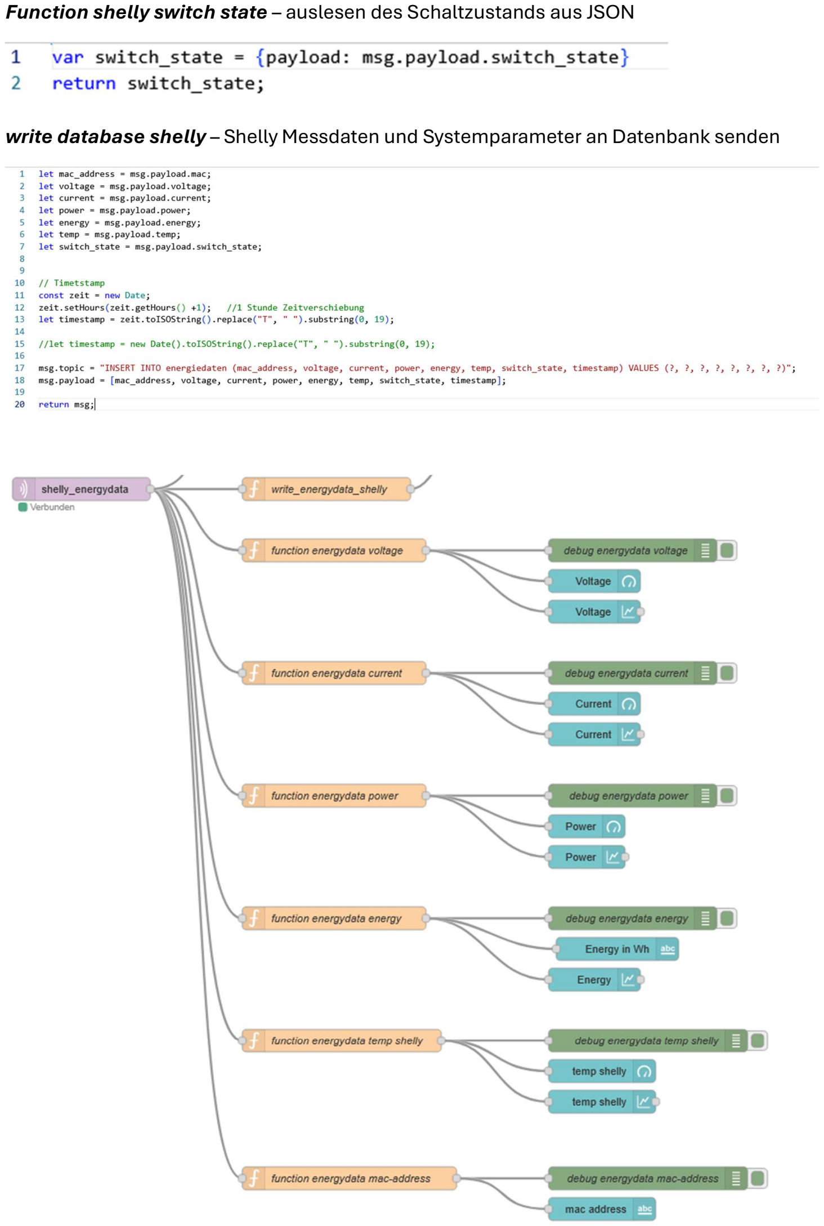
[picture p29: page 33]

Function shelly switch state – auslesen des Schaltzustands aus JSON

write database shelly – Shelly Messdaten und Systemparameter an Datenbank senden function energydata voltage - auslesen der Werte aus JSON

function energydata current - auslesen der Werte aus JSON

function energydata power - auslesen der Werte aus JSON

function energydata energy - auslesen der Werte aus JSON

function energydata temp shelly - auslesen der Werte aus JSON

function energydata mac-address - auslesen der Werte aus JSON

## 6. Bedienung Hardware

Display:
Visualisiert zusätzlich zu Weboberfläche die Messwerte der Sensoren:
- Luftfeuchtigkeit
- Raumtemperatur
- Strom
- Spannung
- Leistung
- Energieverbrauch (wird zurückgesetzt, wenn der Shelly vom Strom getrennt wird)

Taster Display:
- Schaltet das Display für 3 Minuten ein
Taster Schuko 1-2
- Wechselt den Schaltzustand von Steckdose 1&2
o Ein -> Aus
o Aus -> Ein
- Je nach Schaltzustand der Variable muss der Button doppelt betätigt werden, um eine Aktion auszuführen
o Beispiel: Relais 1 ist bereits angezogen und soll nun über diesen Button ausgeschaltet werden. Beim ersten Drücken wir erst Relais 2 eingeschaltet und beim erneuten Drücken werden dann beide ausgeschaltet
Taster Schuko 3-4
- Wechselt den Schaltzustand von Steckdose 3&4
o Ein -> Aus
o Aus -> Ein
- Je nach Schaltzustand der Variable muss der Button doppelt betätigt werden, um eine Aktion auszuführen
o Beispiel: Relais 1 ist bereits angezogen und soll nun über diesen Button ausgeschaltet werden. Beim ersten Drücken wir erst Relais 2 eingeschaltet und beim erneuten Drücken werden dann beide ausgeschaltet

## 7. Sicherheitshinweise

- Beim Arbeiten an elektrischen Anlagen sind in jedem Fall die 5 Sicherheitsregeln zu beachten. Die arbeiten dürfen nur durch eingewiesene Fachkräfte erfolgen! Es besteht Lebensgefahr.
- Bei der Montage ist auf die richtigen Handhaben der Werkzeuge und Materialen zu achten. Andernfalls kann es zu Material- und Personenschäden kommen.
- Die Schutzeinrichtungen sind in regelmäßigen Abständen zu prüfen.
- Betrieb nur im geschlossenen Zustand, nicht gewaltsam önen
- Elektrische Geräte dürfen nicht in Kontakt mit Wasser oder anderen Flüssigkeiten kommen. Nicht für den Betrieb in Feuchräumen, Räume des Verschmutzungsgrad 2 oder höher und Ex-Bereichen ausgelegt
- Verwendung nur mit korrekter Spannung, vermeiden von Überlastung
- Nie unter Last ein- oder ausstecken – Geräte sollten erst ausgeschaltet werden, bevor sie vom Stromnetz getrennt werden.
- Vermeidung von Überhitzung – Lüftungsschlitze dürfen nicht blockiert werden, um eine sichere Wärmeableitung zu ermöglichen.

## 8. Bildquellen

AHT:
https://www.aliexpress.com/item/1005002652456277.html?spm=a2g0o.order_list.order_list_main.4.509418028KDV PR#nav-description
ESP:
https://www.aliexpress.com/item/1005006478706085.html?spm=a2g0o.order_list.order_list_main.30.509418028KD VPR#nav-description
Display:
https://www.aliexpress.com/item/1005007036146351.html?spm=a2g0o.order_list.order_list_main.10.509418028KD VPR#nav-description
Shelly:

https://www.shelly.com/de/products/shelly-plus-1pm
3V3 Step-Down:
https://www.aliexpress.com/item/1005006152209401.html?spm=a2g0o.order_list.order_list_main.111.509418028K DVPR#nav-description
Siemens LS:

https://www.conrad.de/de/p/siemens-5sl61166-siemens-dig-industr-leitungsschutzschalter-1polig-16-a-230-v-400-v-612716.html

Siemens FI/LS:

https://www.conrad.de/de/p/siemens-5sl61166-siemens-dig-industr-leitungsschutzschalter-1polig-16-a-230-v-400-v-612716.html
SRD
- https://ampul.eu/de/relais-magnetische-kontakte/2683-relais-srd-03vdc-sl-c-3v-dc-250v-ac-10a
- https://www.amazon.de/dp/B0B3LJ2JNP?ref=ppx_yo2ov_dt_b_fed_asin_title
MeanWell HDR:

https://m.media-amazon.com/images/I/81hPpZ4lexL.jpg

*Sofern nicht anders angegeben, wurden die Bilder und Grafiken selbst erstellt.

## 9. Klemmplan

## 10. Stromlaufplan
