Laborprojekt/005_Projekt_Kontrollpanel/Dokumentation/Bild Bedienelemente.png

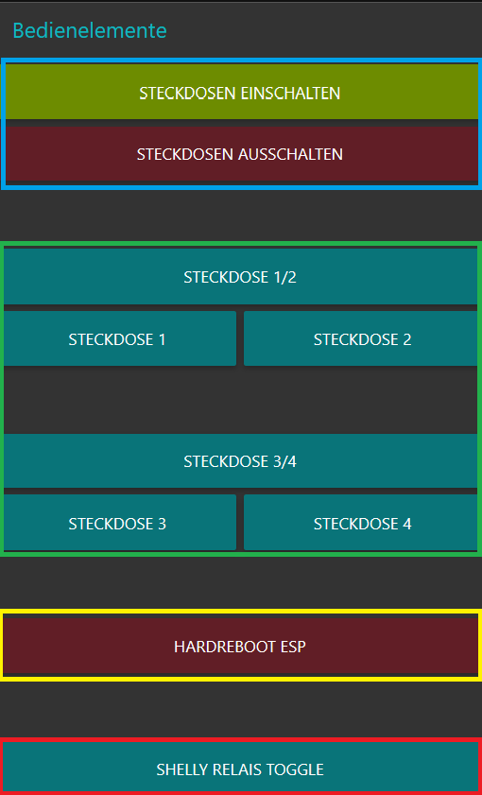
Dokumentation/Bild Bedienelemente.png
