Laborprojekt/005_Projekt_Kontrollpanel/Dokumentation/Screenshot 2025-05-05 222301.png

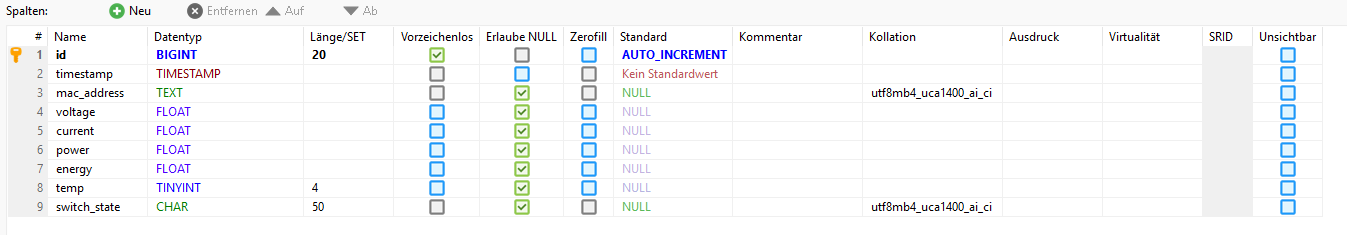
Dokumentation/Screenshot 2025-05-05 222301.png
