Laborprojekt/005_Projekt_Kontrollpanel/Dokumentation/Screenshot 2025-05-05 222405.png

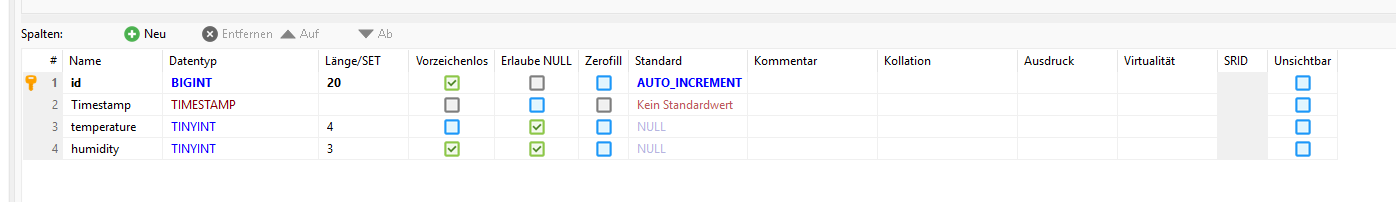
Dokumentation/Screenshot 2025-05-05 222405.png
