Laborprojekt/005_Projekt_Kontrollpanel/3D-Druck/Platte 3V3 modul.stl

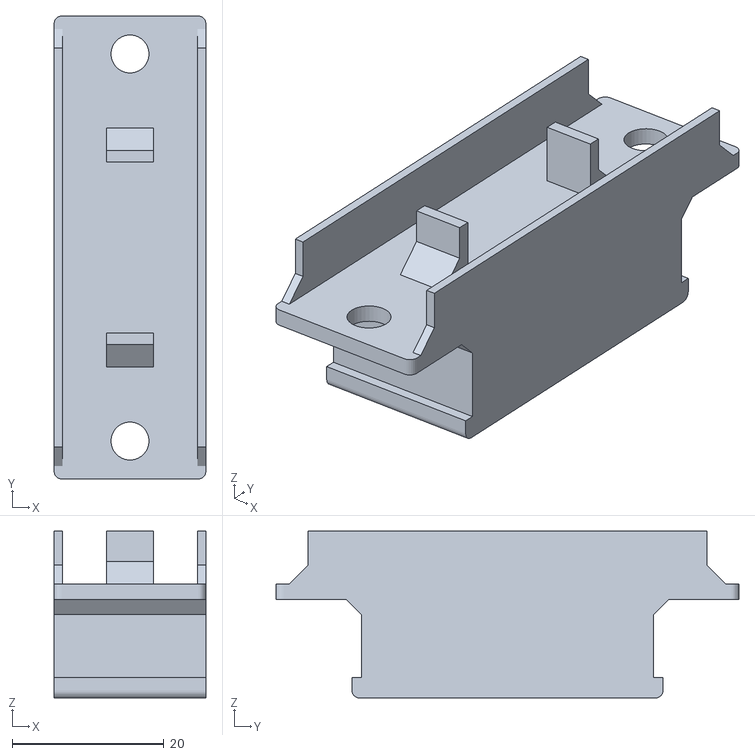
[picture p33: CAD file, 2025-04-02]
3D-Druck/Platte 3V3 modul.stl
20.0 x 61.0 x 22.0
