Laborprojekt/005_Projekt_Kontrollpanel/Dokumentation/Installationszeichnung/162143235-21-5su13566kk10/5su13566kk10.stl

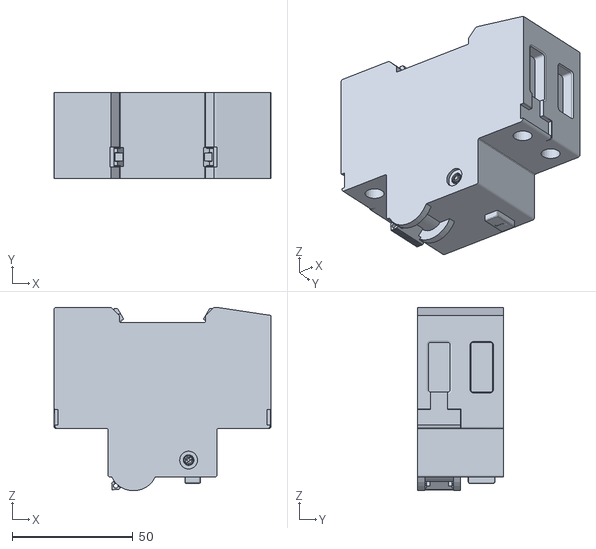
[picture p34: CAD file, 2025-04-30]
Dokumentation/Installationszeichnung/162143235-21-5su13566kk10/5su13566kk10.stl
89.8 x 35.4 x 75.9
