Laborprojekt/005_Projekt_Kontrollpanel/Dokumentation/Installationszeichnung/162143285-21-5sl61166/5sl61166.stl

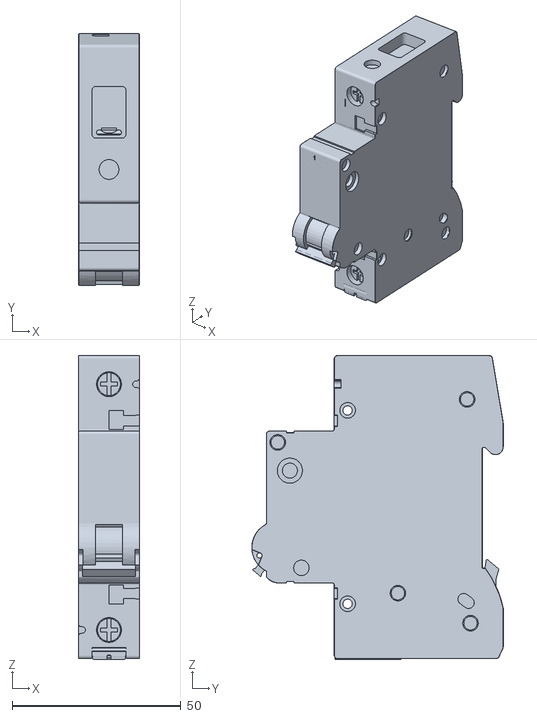
[picture p35: CAD file, 2025-04-30]
Dokumentation/Installationszeichnung/162143285-21-5sl61166/5sl61166.stl
18.0 x 74.5 x 90.1
