Laborprojekt/005_Projekt_Kontrollpanel/Dokumentation/Installationszeichnung/pxc_3030514_03_00_D-ST-2-5-QUATTRO_3D.stp

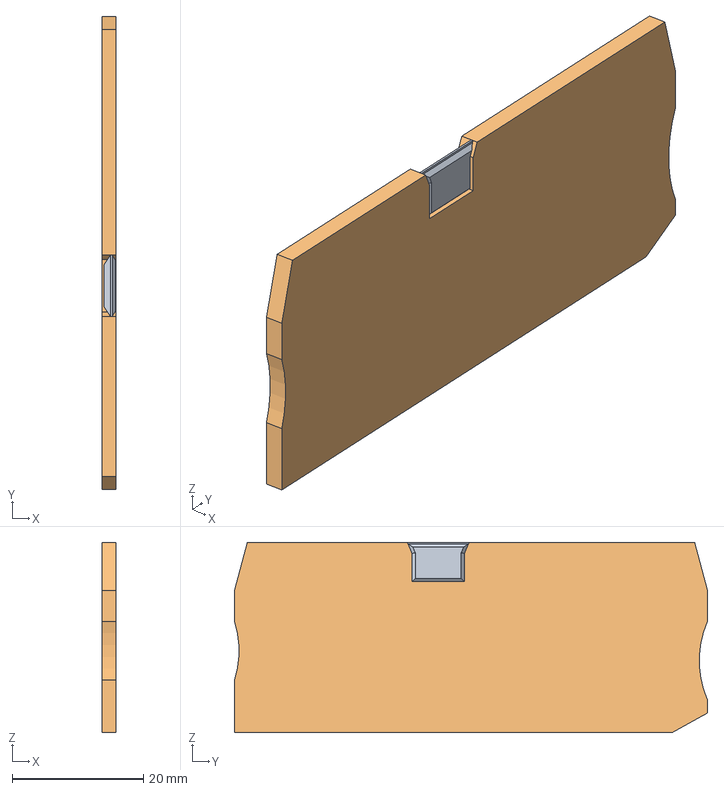
[picture p36: CAD file, 2025-04-30]
Dokumentation/Installationszeichnung/pxc_3030514_03_00_D-ST-2-5-QUATTRO_3D.stp
2.20 x 72.2 x 29.0 mm
D-ST_2.5_QUATTRO_Bridge_element1
D_ST_2.5_QUATTRO-Body
