Laborprojekt/005_Projekt_Kontrollpanel/Dokumentation/Installationszeichnung/shelly-1pm-1.snapshot.1/Shelly 1PM.step

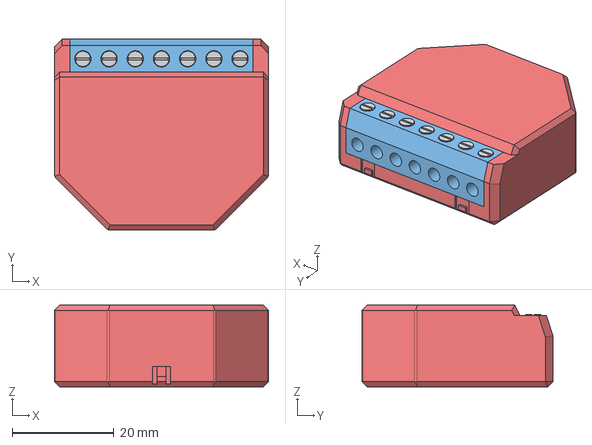
[picture p37: CAD file, 2025-04-30]
Dokumentation/Installationszeichnung/shelly-1pm-1.snapshot.1/Shelly 1PM.step
42.0 x 37.5 x 16.0 mm
Countersunk (Flat) Head Screw DIN 963 - M1.6 x 8 Steel 4.6 Plain v1 x 7
