Laborprojekt/005_Projekt_Kontrollpanel/3D-Druck/Platte 12V modul.stl

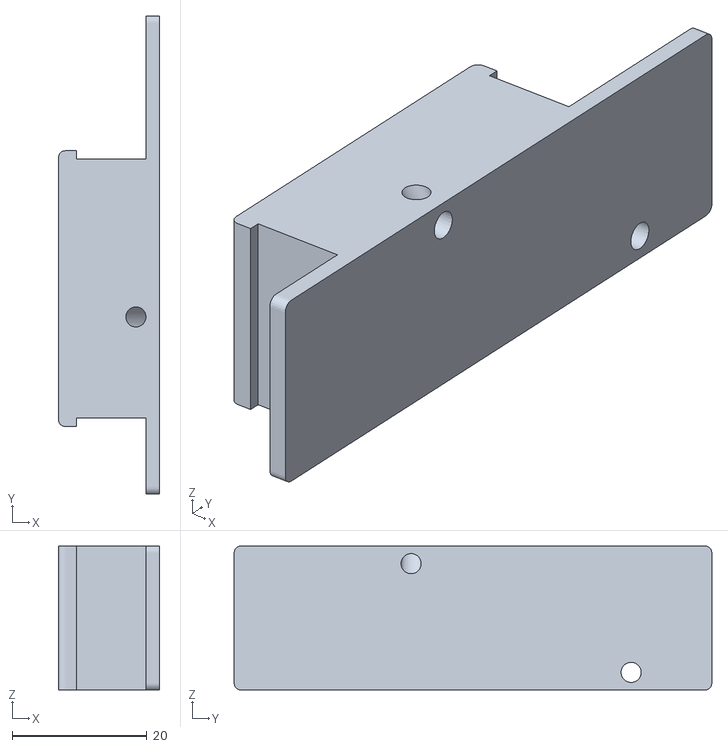
[picture p38: CAD file, 2025-04-02]
3D-Druck/Platte 12V modul.stl
15.0 x 71.0 x 21.4
