Laborprojekt/005_Projekt_Kontrollpanel/Dokumentation/Installationszeichnung/pxc_3030161_10_04_FBS-2-5_3D.stp

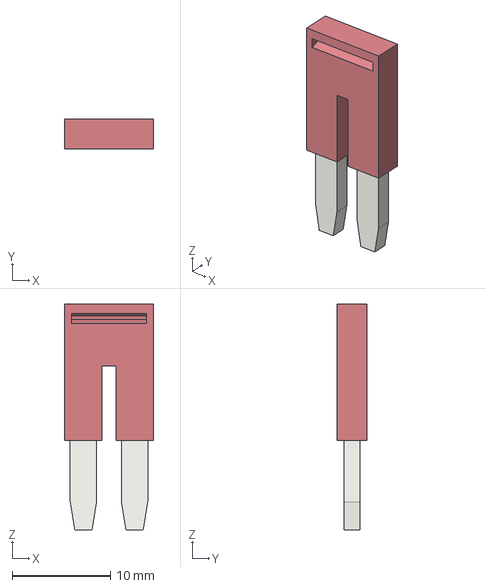
[picture p39: CAD file, 2025-04-30]
Dokumentation/Installationszeichnung/pxc_3030161_10_04_FBS-2-5_3D.stp
9.00 x 3.00 x 23.0 mm
