Laborprojekt/005_Projekt_Kontrollpanel/3D-Druck/Deckel 3V3 Modul.stl

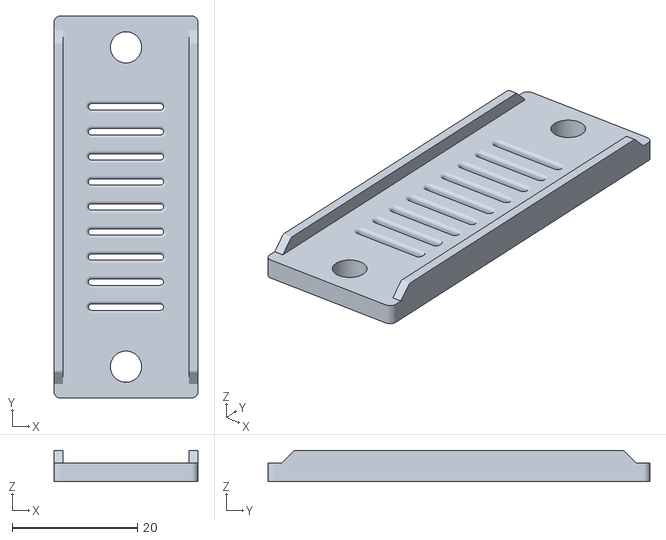
[picture p40: CAD file, 2025-04-02]
3D-Druck/Deckel 3V3 Modul.stl
23.0 x 61.0 x 5.00
