Laborprojekt/005_Projekt_Kontrollpanel/Dokumentation/Installationszeichnung/pxc_3211760_18_03_PT-4-BU_3D.stp

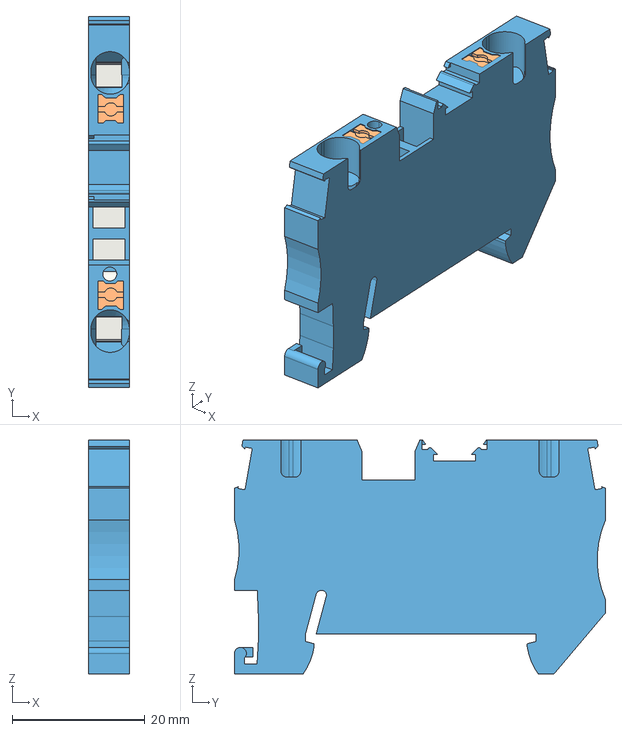
[picture p41: CAD file, 2025-04-30]
Dokumentation/Installationszeichnung/pxc_3211760_18_03_PT-4-BU_3D.stp
6.15 x 55.9 x 35.3 mm
