Laborprojekt/005_Projekt_Kontrollpanel/3D-Druck/Relais_Platte.stl

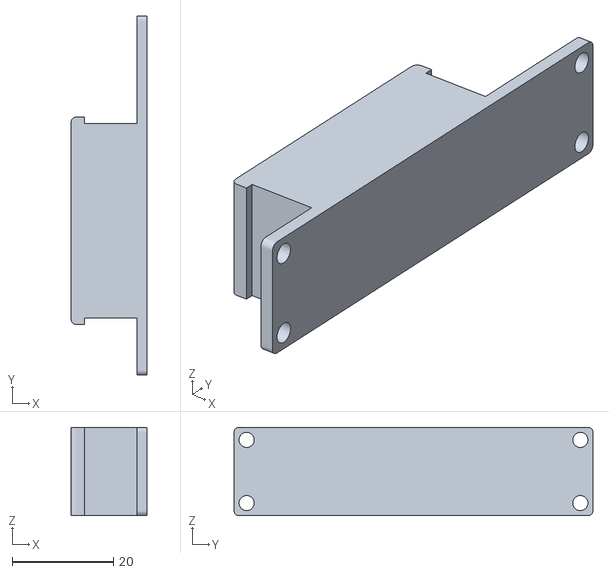
[picture p42: CAD file, 2025-03-25]
3D-Druck/Relais_Platte.stl
15.0 x 71.0 x 17.5
