Laborprojekt/005_Projekt_Kontrollpanel/3D-Druck/Halterung 221-415.stl

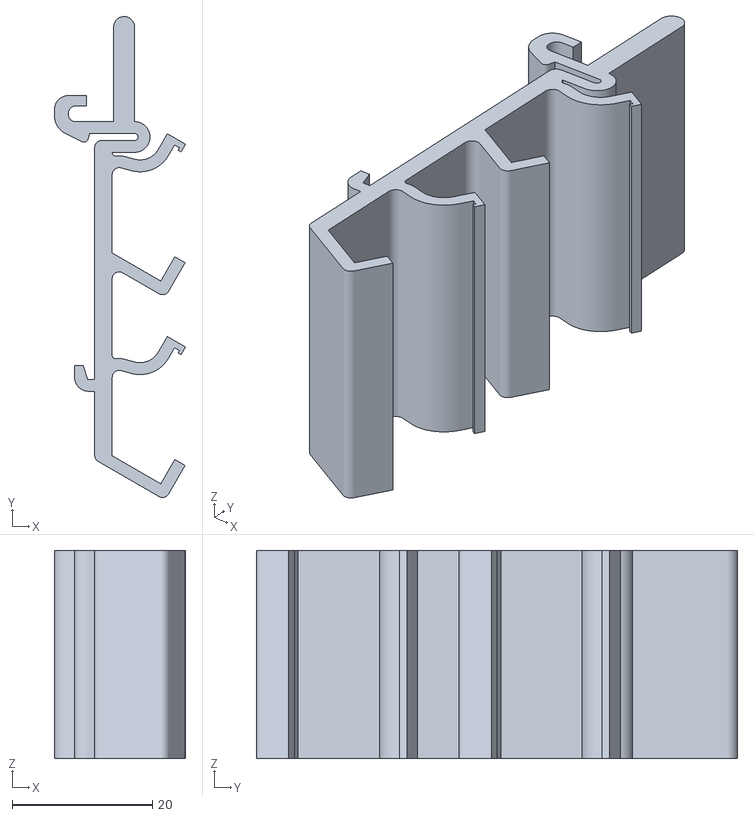
[picture p43: CAD file, 2025-03-25]
3D-Druck/Halterung 221-415.stl
18.7 x 68.6 x 29.8
