Laborprojekt/005_Projekt_Kontrollpanel/Dokumentation/Installationszeichnung/pxc_3030417_05_00_D-ST-2-5_3D.stp

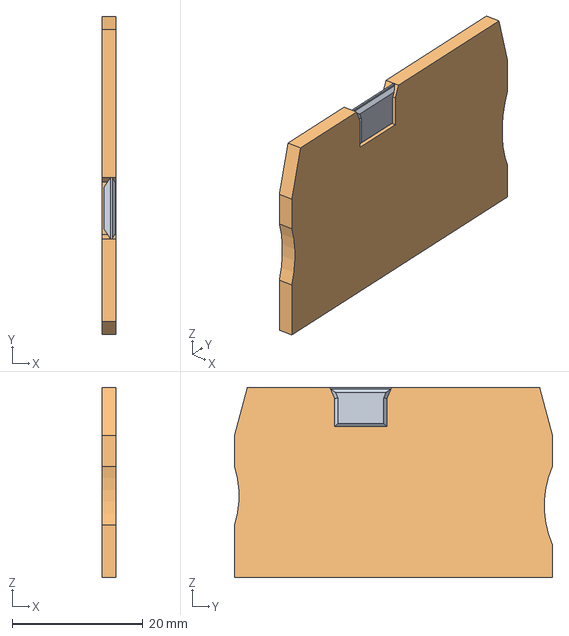
[picture p44: CAD file, 2025-04-30]
Dokumentation/Installationszeichnung/pxc_3030417_05_00_D-ST-2-5_3D.stp
2.20 x 48.6 x 29.0 mm
D-ST_2.5-Bridge_element1
D-ST_2.5-Body
