Laborprojekt/005_Projekt_Kontrollpanel/3D-Druck/Halterung 221-413.stl

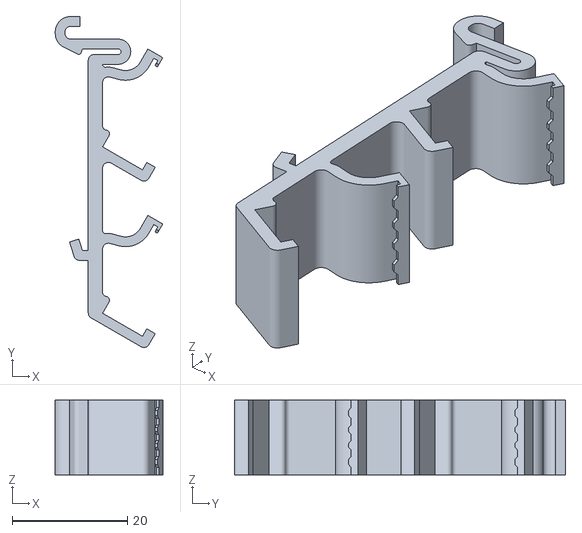
[picture p45: CAD file, 2025-03-25]
3D-Druck/Halterung 221-413.stl
18.7 x 57.6 x 13.0
