Laborprojekt/005_Projekt_Kontrollpanel/Dokumentation/Installationszeichnung/HDR-60.stp

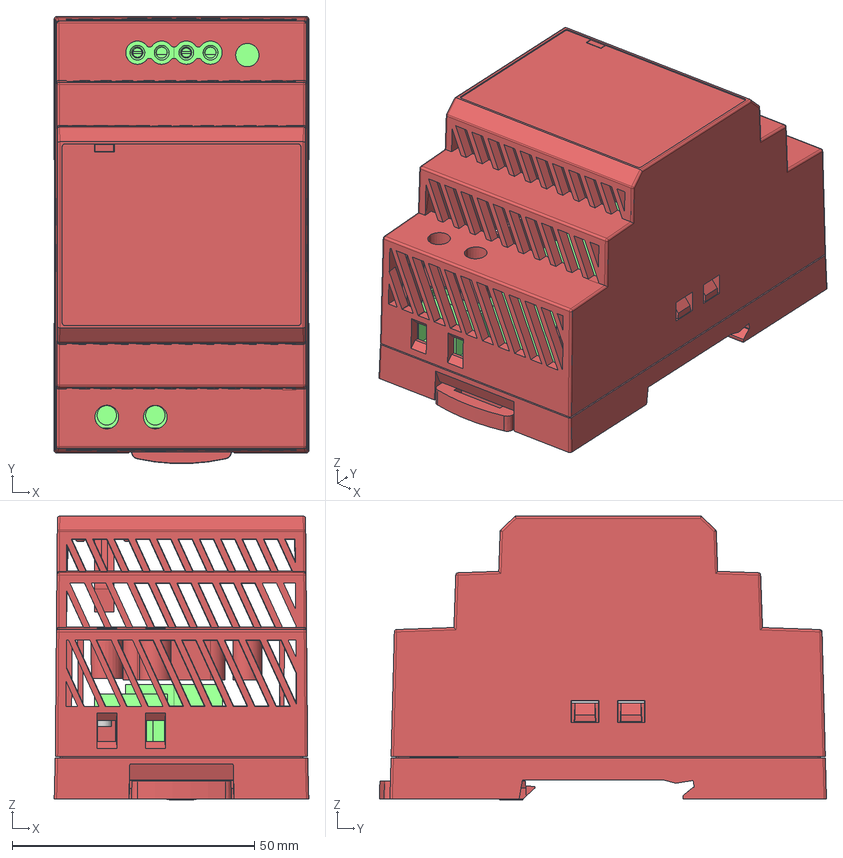
[picture p46: CAD file, 2025-04-30]
Dokumentation/Installationszeichnung/HDR-60.stp
52.5 x 92.2 x 58.6 mm
a1 x 2
PCB.1 x 2
KNX-201511_16_2.PRT
HDR-上蓋組
