Laborprojekt/005_Projekt_Kontrollpanel/3D-Druck/Din_Rail_Mount_v3_v2.stl

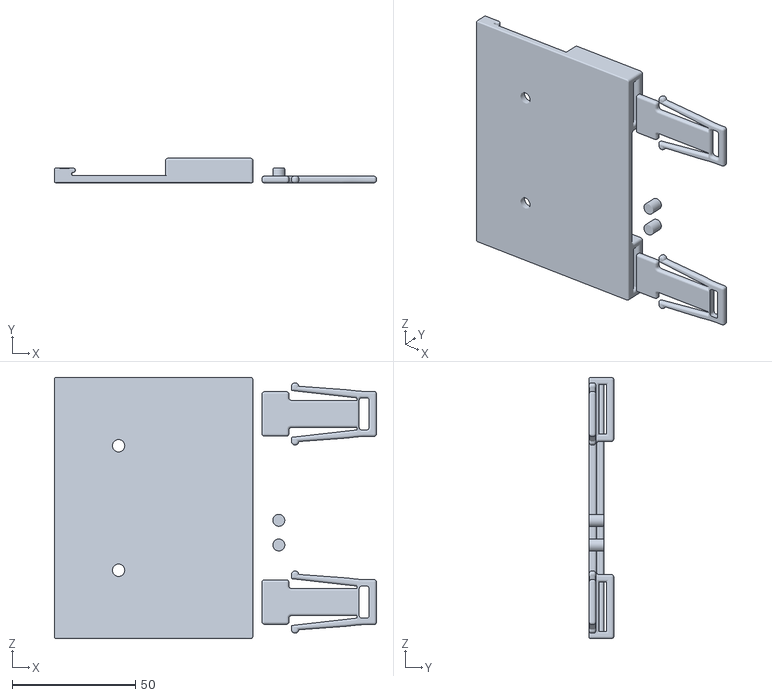
[picture p47: CAD file, 2025-03-24]
3D-Druck/Din_Rail_Mount_v3_v2.stl
130.6 x 10.0 x 106.0
