Laborprojekt/005_Projekt_Kontrollpanel/Dokumentation/Installationszeichnung/pxc_3209578_22_05_PT-2-5-QUATTRO_3D.stp

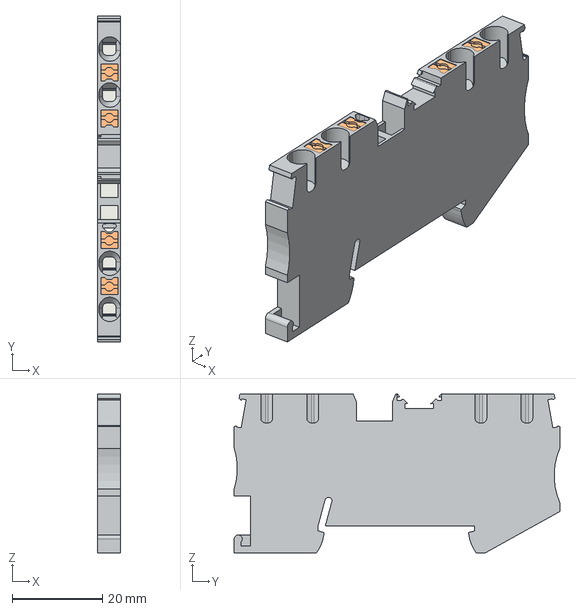
[picture p48: CAD file, 2025-04-30]
Dokumentation/Installationszeichnung/pxc_3209578_22_05_PT-2-5-QUATTRO_3D.stp
5.15 x 72.2 x 35.3 mm
