Laborprojekt/005_Projekt_Kontrollpanel/Dokumentation/Installationszeichnung/pxc_3030420_04_00_D-ST-4_3D.stp

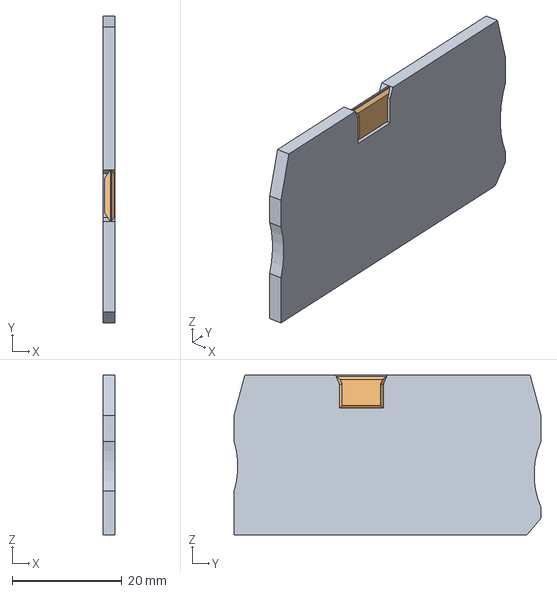
[picture p49: CAD file, 2025-04-30]
Dokumentation/Installationszeichnung/pxc_3030420_04_00_D-ST-4_3D.stp
2.20 x 55.9 x 29.0 mm
D-ST4-Body
D-ST4_Bridge_element1
