Laborprojekt/005_Projekt_Kontrollpanel/Dokumentation/Installationszeichnung/pxc_3022276_08_02_CLIPFIX-35-5_3D.stp

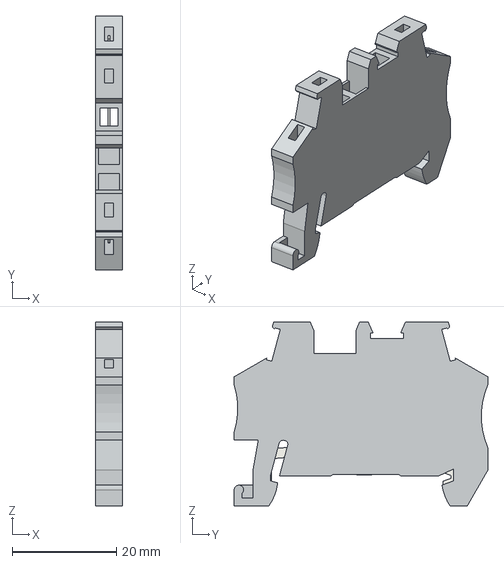
[picture p50: CAD file, 2025-04-30]
Dokumentation/Installationszeichnung/pxc_3022276_08_02_CLIPFIX-35-5_3D.stp
5.15 x 48.6 x 35.2 mm
