Laborprojekt/005_Projekt_Kontrollpanel/(list of files, cad)

Other CAD files:
Dokumentation/Installationszeichnung/pxc_3211766_13_02_PT-4-PE_3D.stp
3D-Druck/Baugruppe1.iam
3D-Druck/Deckel 3V3 Modul.ipt
3D-Druck/Platte 12V modul.ipt
3D-Druck/Platte 3V3 modul.ipt
3D-Druck/Relais_Platte.ipt
Dokumentation/Installationszeichnung/HDR-60/HDR-60/HDR-60.ipt
Dokumentation/Installationszeichnung/N36-C/N36-C/Kuciste N36-C (11.12.2024).ipt
Dokumentation/Installationszeichnung/N36-C/N36-C/Maskla N36-C.ipt
Dokumentation/Installationszeichnung/N36-C/N36-C/N36-C.iam
Dokumentation/Installationszeichnung/N36-C/N36-C/Vrata N36-C.ipt
Dokumentation/Installationszeichnung/OldVersions/UV.0002.iam
Dokumentation/Installationszeichnung/UV.iam
Dokumentation/Installationszeichnung/shelly-1pm-1.snapshot.1/Shelly 1PM/SHWH_DIN_Klammer_V2.ipt
Dokumentation/Installationszeichnung/shelly-1pm-1.snapshot.1/Shelly 1PM/Shelly 1PM/Shelly 1PM.ipt
Dokumentation/Installationszeichnung/shelly-1pm-1.snapshot.1/Shelly 1PM/Shelly_plus-V1-A-WH.ipt
OldVersions/Deckel 3V3 Modul.0004.ipt
OldVersions/Platte 12V modul.0001.ipt
OldVersions/Platte 3V3 modul.0003.ipt
OldVersions/Relais_Platte.0003.ipt
