Laborprojekt/005_Projekt_Kontrollpanel/Bedienungsanleitung Kontrollpanel.docx

# Bedienungsanleitung Kontrollpanel

## Anlage in Betrieb nehmen

## Broker und Datenbank einschalten

## Shelly

### Shelly in App einbinden

### MQTT parametrieren

### Skripte auf Shelly aktivieren

## Node-Red

### Bedienelemente


Gruppenschaltung Steckdose

- Schaltet alle Steckdosen gesammelt ein oder aus

Button Steckdosen

- Wechselt den Schaltzustand der jeweiligen Steckdosengruppe oder Steckdose
  - Ein -> Aus
  - Aus -> Ein

Hardreboot ESP

- Trennt die Stromversorgung vom ESP und erzwingt dadurch einen Neustart

Shelly Relais toggle

- Wechselt den Schaltzustand internen Shelly Relais
  - Ein -> Aus
  - Aus -> Ein
- Ist das Relais ausgeschaltet wird das Netzteil, der ESP und die Steckdosen nicht mit Strom versorgt. Das Relais kann über die Shelly App oder die Node-Red Weboberfläche geschaltet werden.

### Raumwerte

### Energiewerte

### Log History

## Bedienung Hardware

### Display:

Visualisiert zusätzlich zu Weboberfläche die Messwerte der Sensoren:

- Luftfeuchtigkeit
- Raumtemperatur
- Strom
- Spannung
- Leistung
- Energieverbrauch (wird zurückgesetzt, wenn der Shelly vom Strom getrennt wird)

### Taster Display:

- Schaltet das Display für 3 Minuten ein

### Taster Schuko 1-2

- Wechselt den Schaltzustand von Steckdose 1&2
  - Ein -> Aus
  - Aus -> Ein

### Taster Schuko 3-4

- Wechselt den Schaltzustand von Steckdose 3&4
  - Ein -> Aus
  - Aus -> Ein

### Schalter LED

- Mit diesem Schalter kann die Ringbeleuchtung der beiden Steckdosentaster eingeschaltet und ausgeschaltet werden

## Sicherheitshinweise
