Laborprojekt/005_Projekt_Kontrollpanel/Ideenskizze/Architektur Projektarbeit.pdf

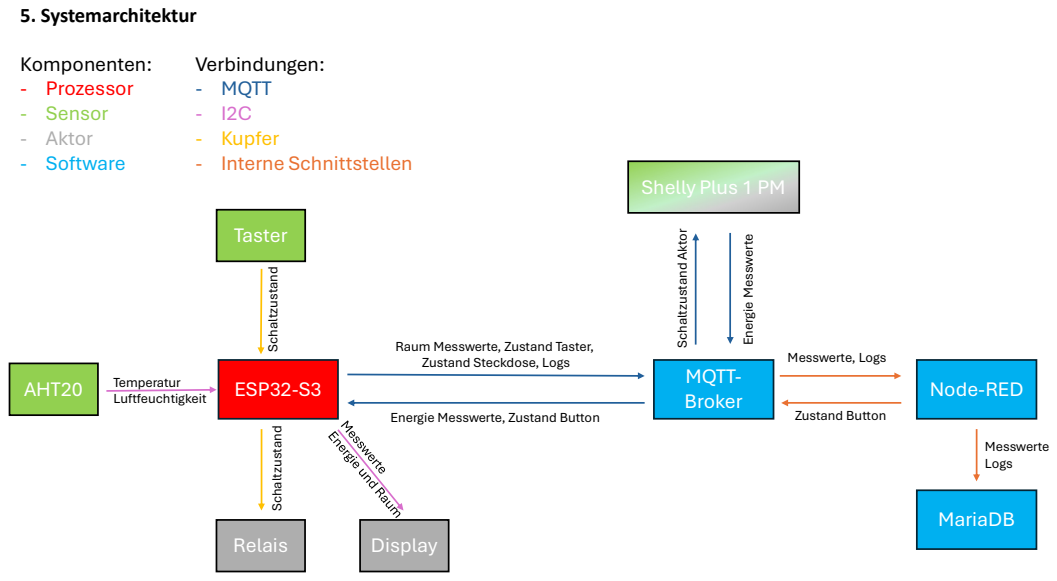
[picture p53: page 1]
ESP32-S3; MQTT-; Broker; Node-RED; MariaDB; Komponenten: - Prozessor - Sensor - Aktor - Software; Verbindungen: - MQTT - I2C - Kupfer - Interne Schnittstellen; AHT20; Taster; Relais; Display; Shelly Plus 1 PM Schaltzustand Aktor; Energie Messwerte; Messwerte, Logs; Messwerte Logs; Temperatur; Luftfeuchtigkeit; Schaltzustand Schaltzustand; Zustand Button; 5. Systemarchitektur

Raum Messwerte, Zustand Taster,
Zustand Steckdose, Logs

Energie Messwerte, Zustand Button
