Laborprojekt/005_Projekt_Kontrollpanel/Dokumentation/Stromlaufpläne.pdf

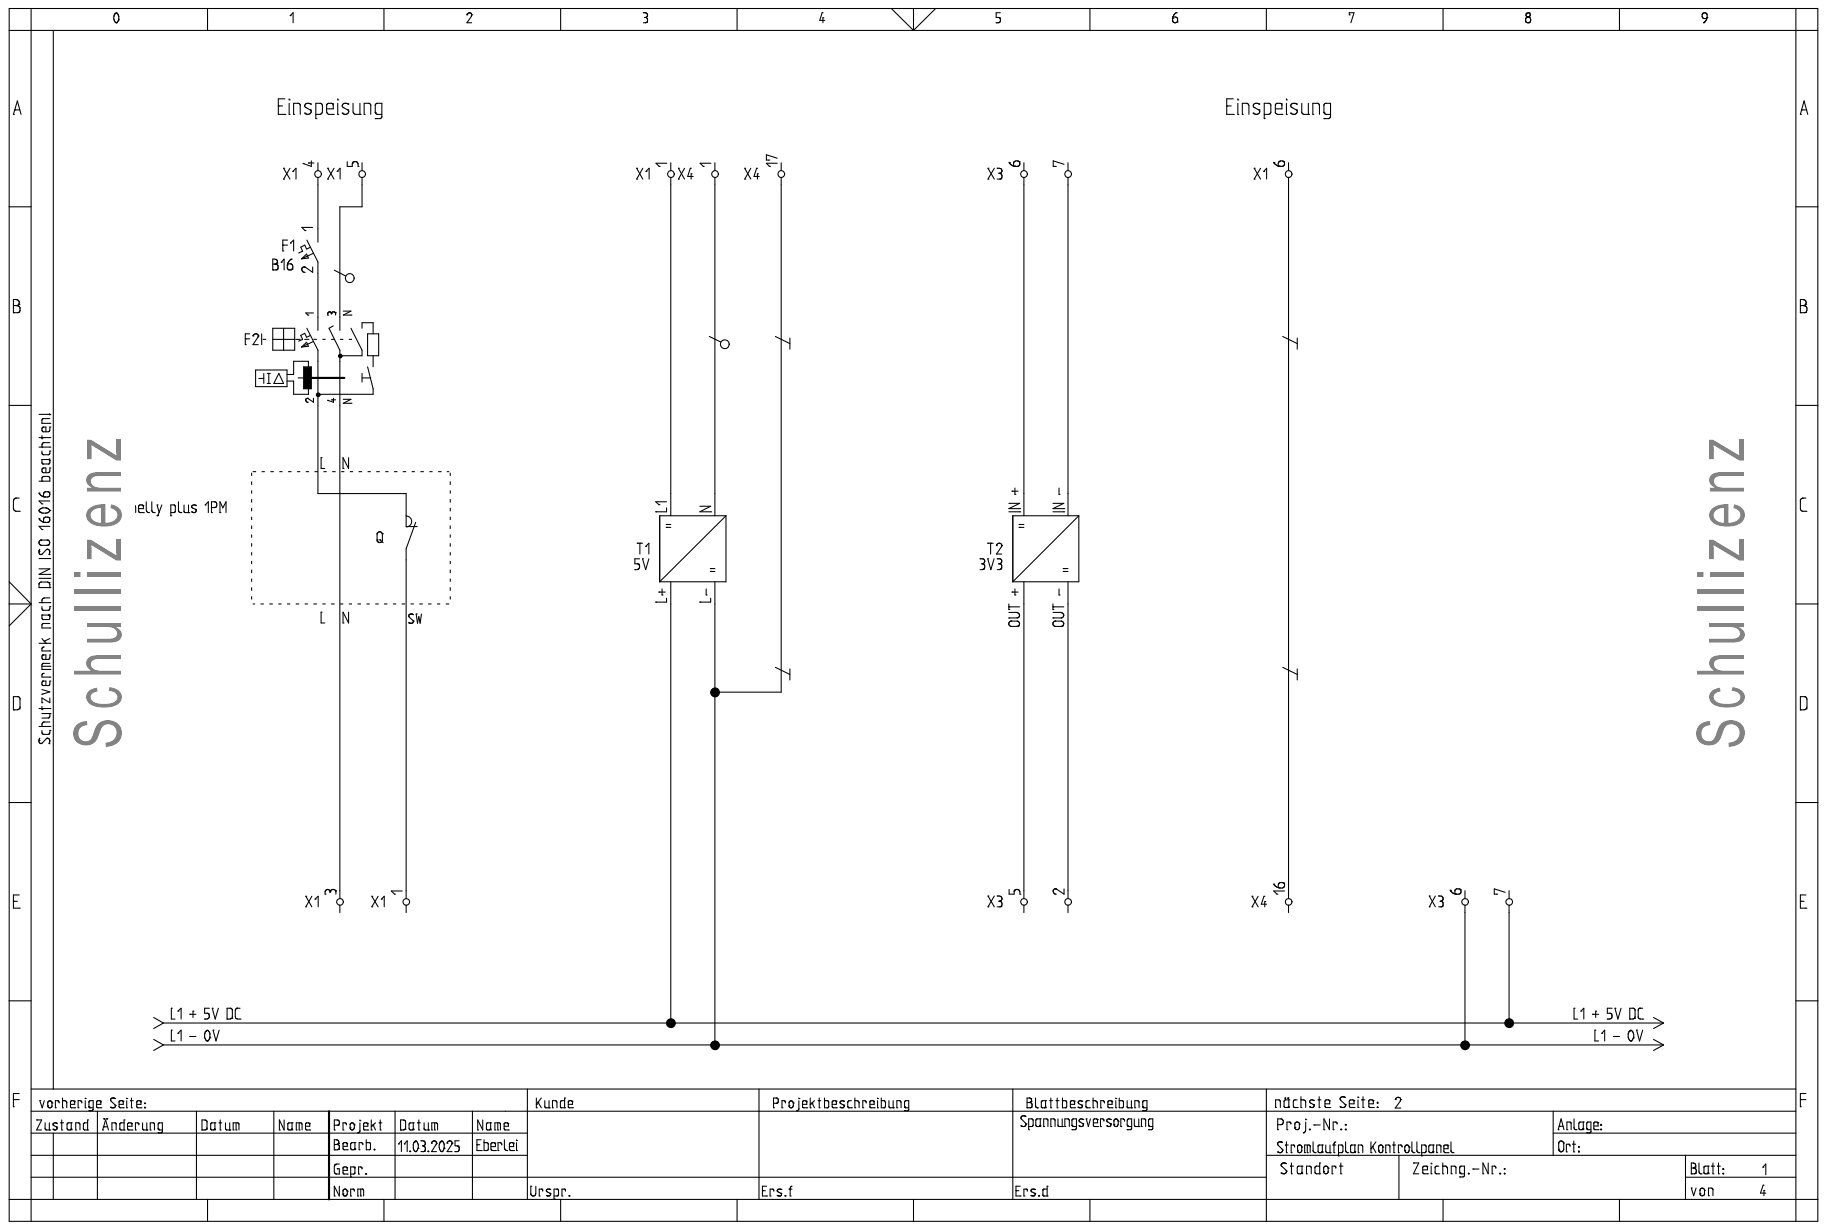
[picture p57: page 1]

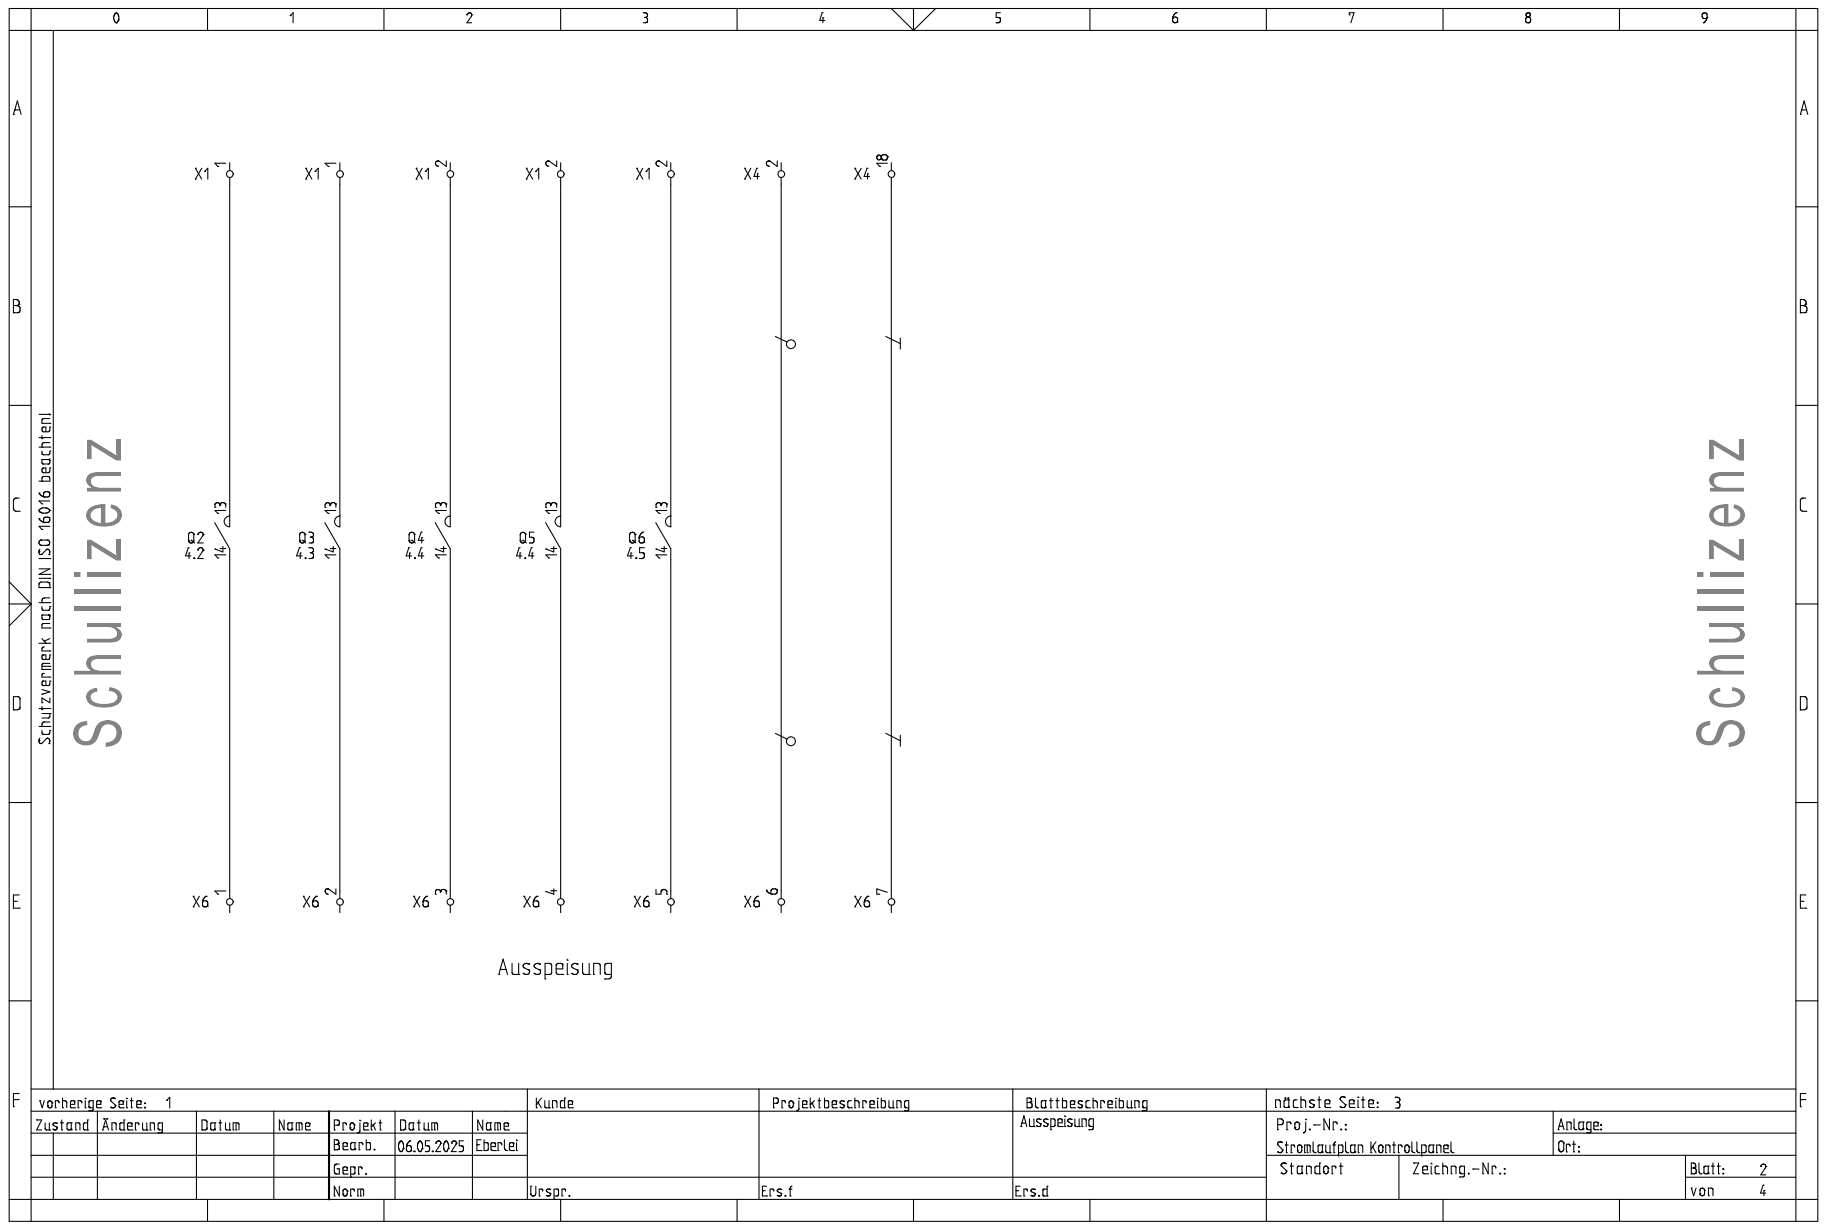
[picture p58: page 2]

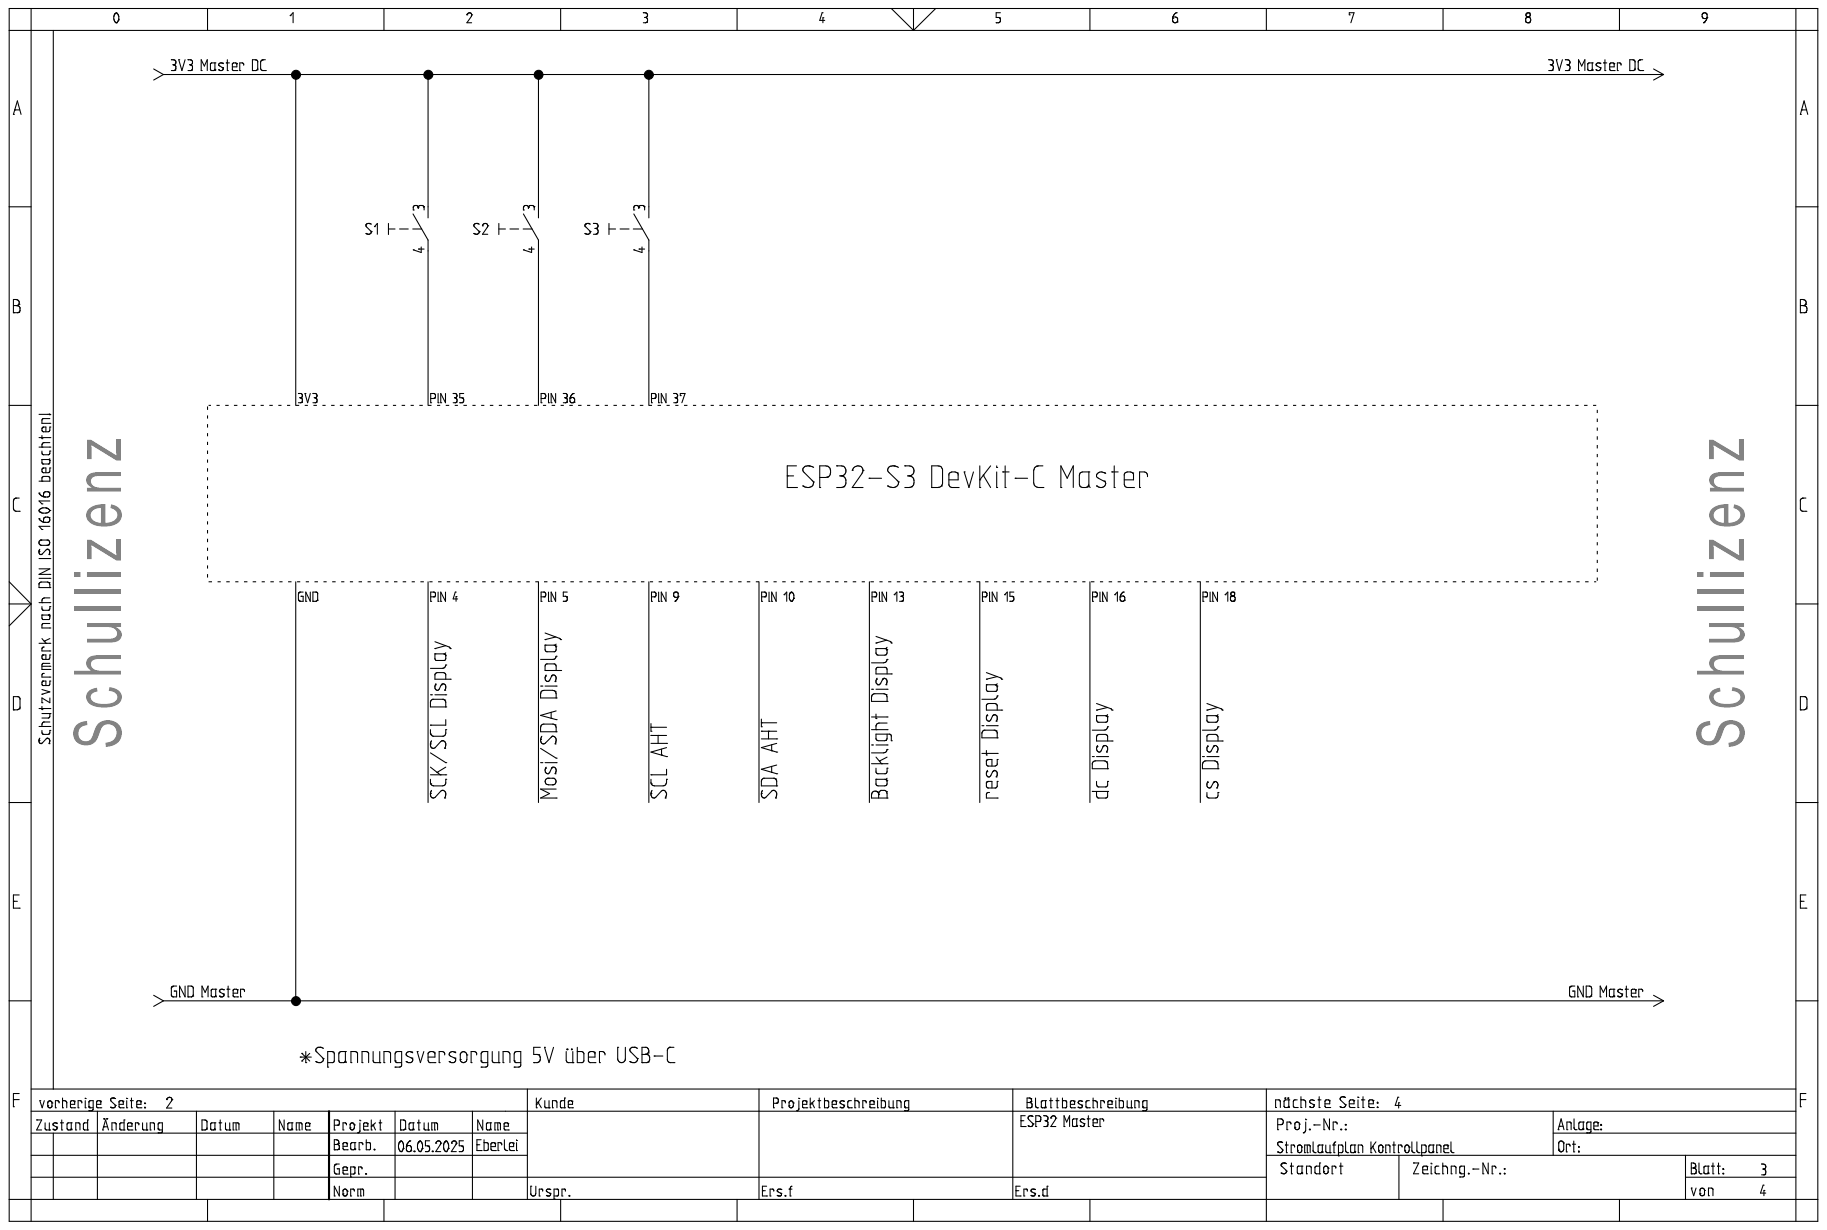
[picture p59: page 3]

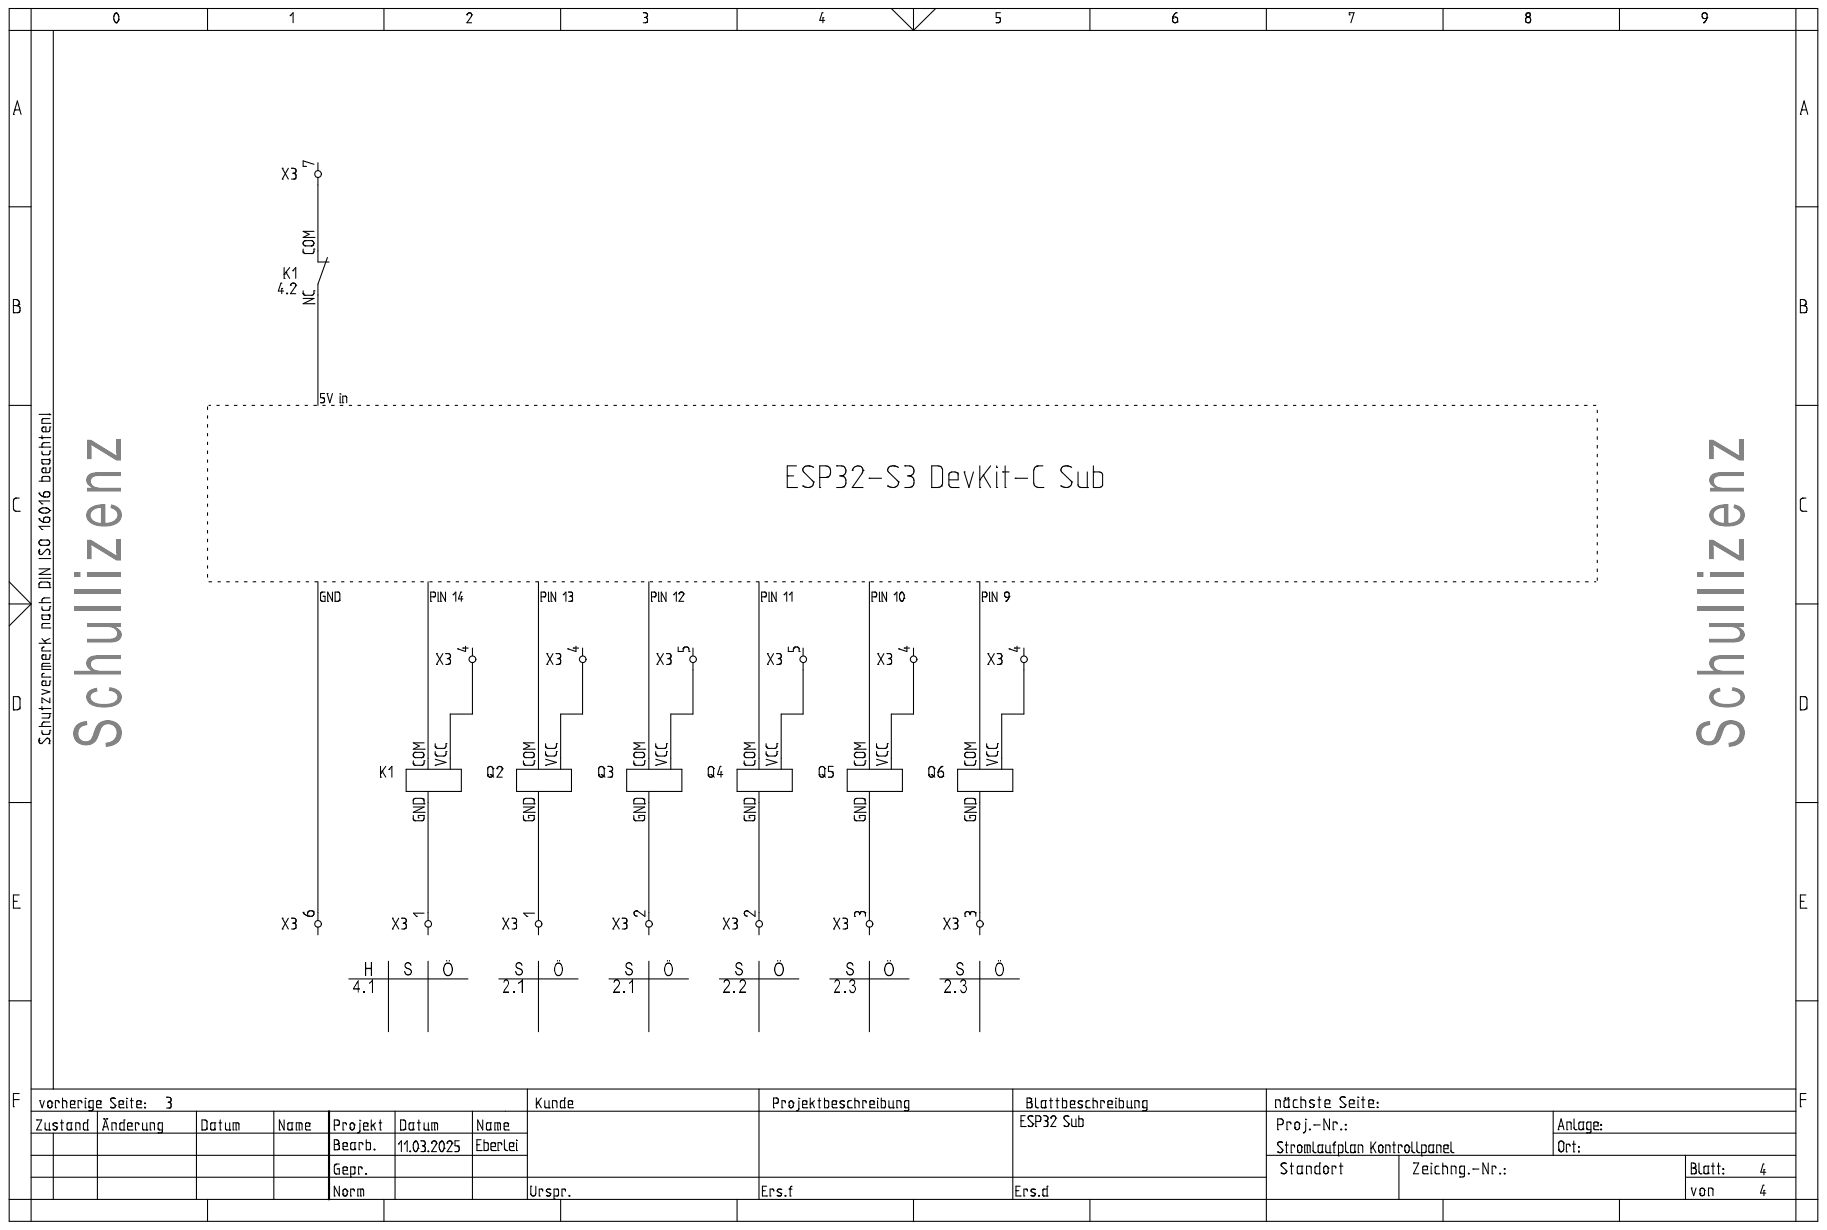
[picture p60: page 4]
