Laborprojekt/005_Projekt_Kontrollpanel/Ideenskizze/Stromlaufplan Kontrollpanel.pdf

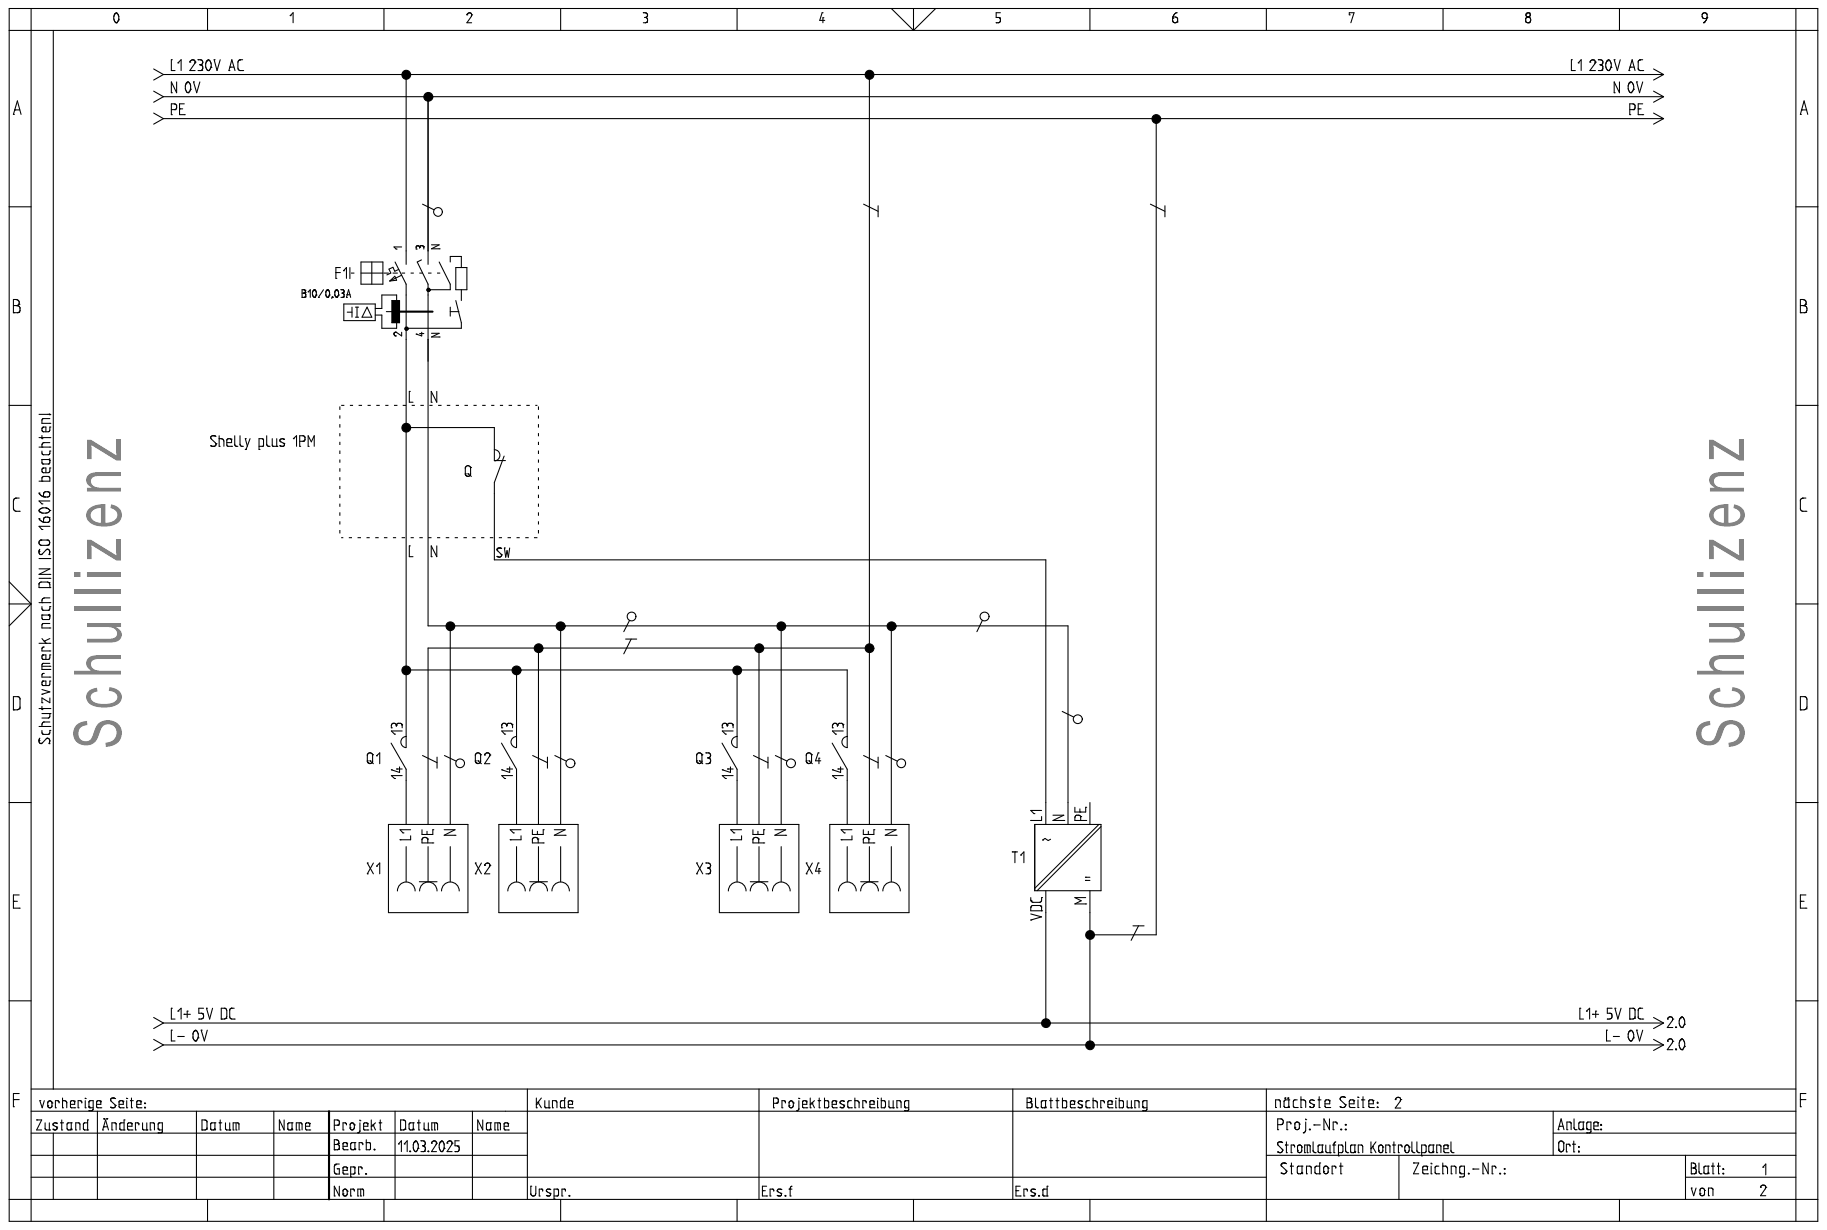
[picture p61: page 1]

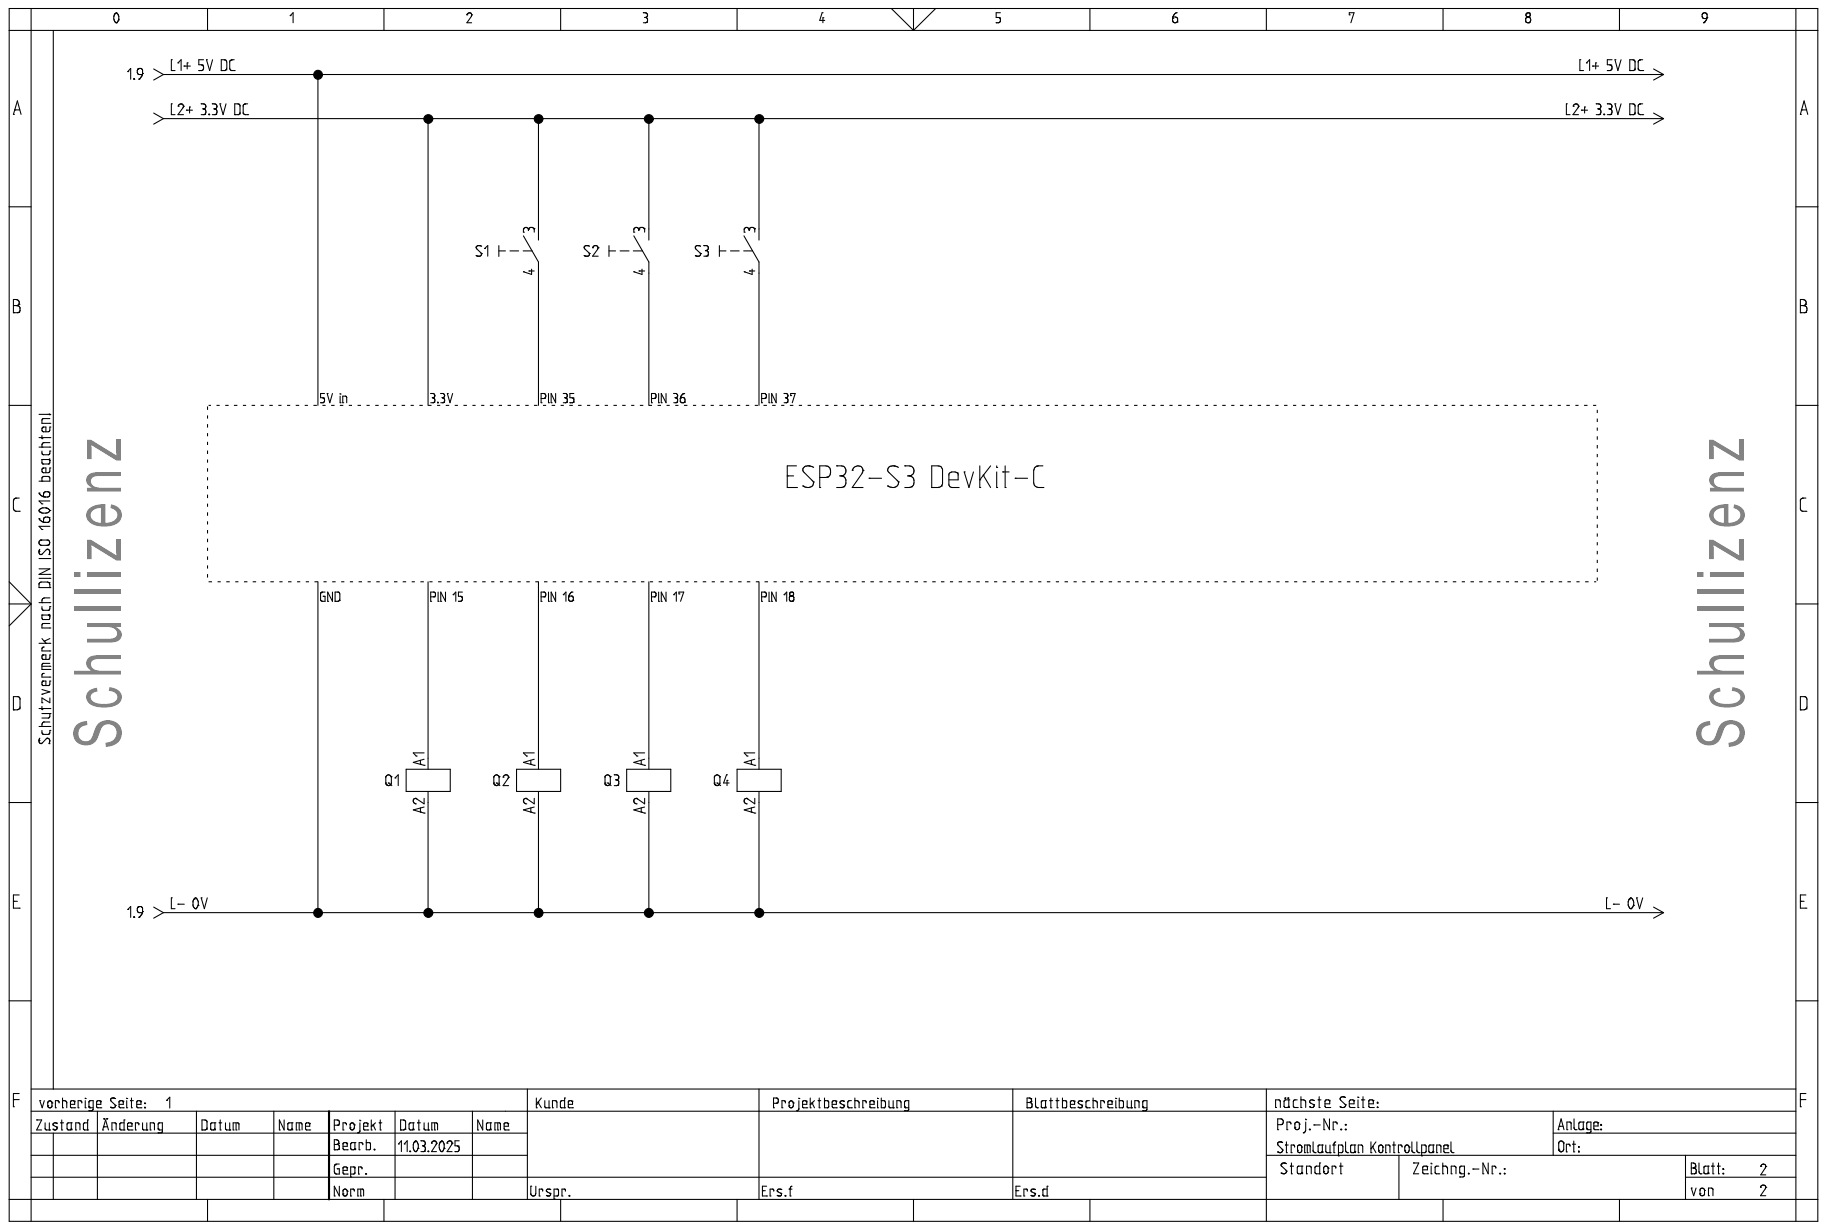
[picture p62: page 2]
