Laborprojekt/005_Projekt_Kontrollpanel/(commit log)

2025-03-18 MQTT_ABO
    - reboot und schuko1 Relais wird angesteuert
    - Abonnieren der Schalter vom Dashboard
    [Kontrollpanel.py]
2025-03-23 3d Models
    [Baugruppe1.iam, Din_Rail_Mount_v3_v2.stl, Relais_Platte.0002.ipt, Relais_Platte.ipt, Relais_Platte.stl]
2025-03-25 Update Relais und Interrups
2025-04-01 3d Modelle
    [Deckel 3V3 Modul.0004.ipt, Deckel 3V3 Modul.ipt, Deckel 3V3 Modul.stl, Platte 12V modul.0001.ipt, Platte 12V modul.ipt, Platte 12V modul.stl, Platte 3V3 modul.0003.ipt, Platte 3V3 modul.ipt]
2025-04-13 Einbindung AHT und Datenbank
2025-04-14 Upgrade
    - Shelly switch state live aktualisierung im dashboard
    - shelly relais über dashboard shaltbar
    - organisation repository (Ordner für Slicer Dateieb)
    - Integration Display
    [Deckel 3V3 Modul.stl, Din_Rail_Mount_v3_v2.stl, Halterung 221-413.stl, Halterung 221-415.stl, Platte 12V modul.stl, Platte 3V3 modul.stl, Relais_Platte.stl]
2025-04-19 Umbau auf Taster und automatische abschaltung
2025-04-30 Kommentare einfügen und Variablen optisch aufarbeiten
2025-04-30 3d Modell
    [5sl61166.stl, 5su13566kk10.stl, HDR-60.ipt, HDR-60.stp, Kuciste N36-C (11.12.2024).ipt, Maskla N36-C.ipt, N36-C.iam, SHWH_DIN_Klammer_V2.ipt]
2025-05-06 repository aufräumen
    [Baugruppe1.iam, Deckel 3V3 Modul.ipt, Klemmplan.xlsx, Platte 12V modul.ipt, Platte 3V3 modul.ipt, Relais_Platte.ipt]
